marcelomata/MATLAB/2 Spring 2017/Nonlinear Control/html/HW1_01.png

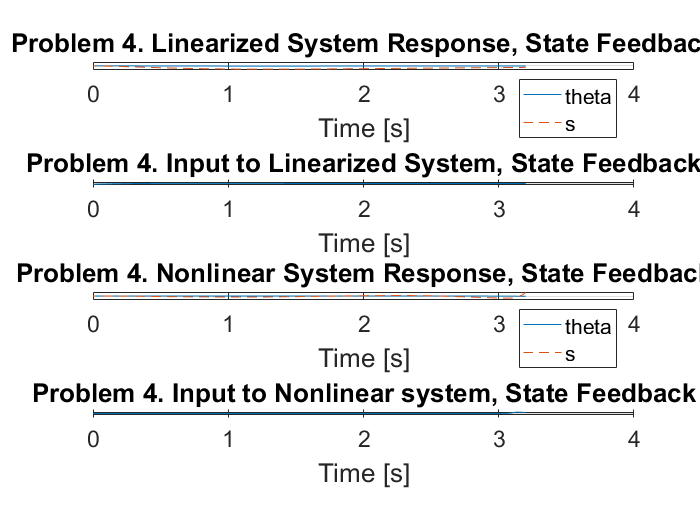
2 Spring 2017/Nonlinear Control/html/HW1_01.png
