marcelomata/MATLAB/2 Spring 2017/Nonlinear Control/HW2/fig2.jpg

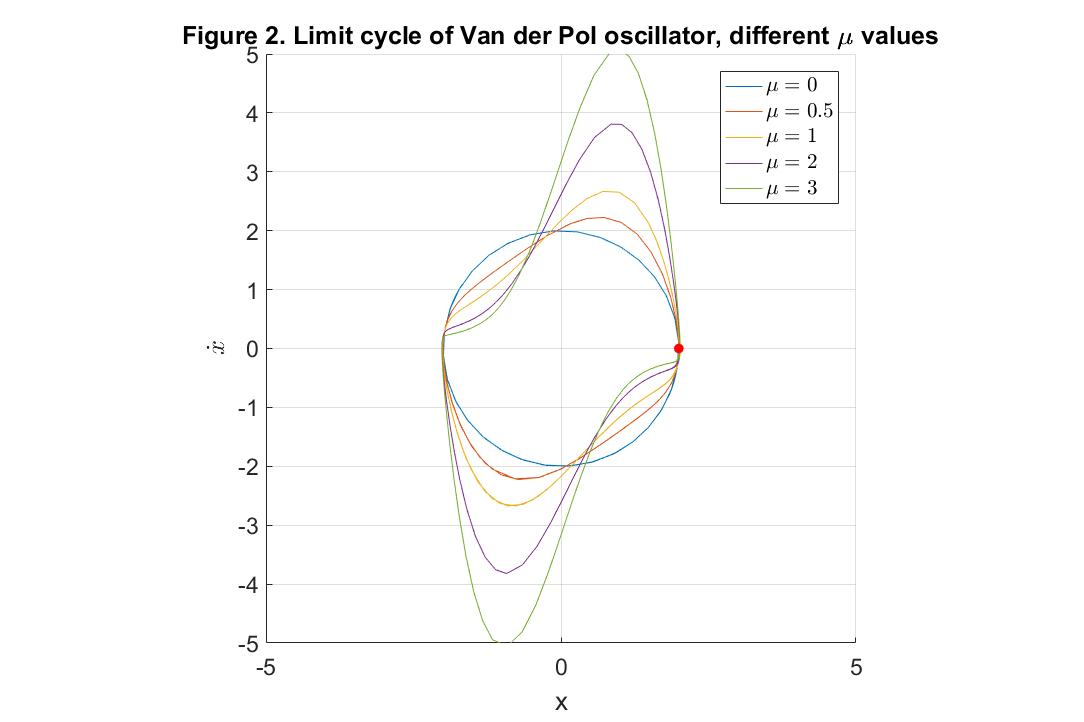
2 Spring 2017/Nonlinear Control/HW2/fig2.jpg
