marcelomata/MATLAB/2 Spring 2017/Nonlinear Control/HW2/fig4.jpg

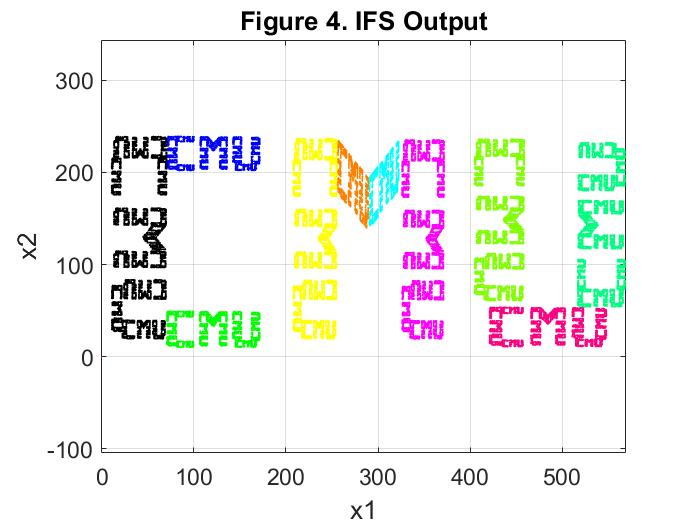
2 Spring 2017/Nonlinear Control/HW2/fig4.jpg
