marcelomata/MATLAB/2 Spring 2017/Nonlinear Control/HW8/html/HW8_3_01.png

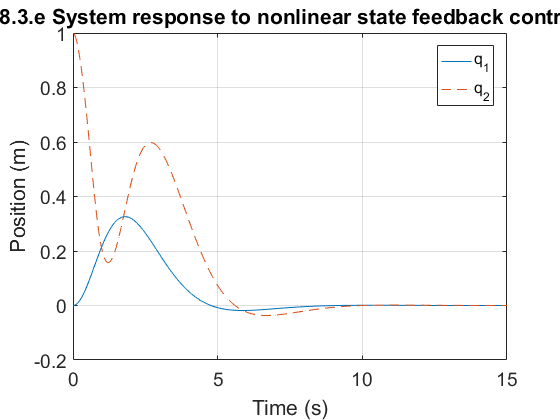
2 Spring 2017/Nonlinear Control/HW8/html/HW8_3_01.png
