marcelomata/MATLAB/Minitaur models/SM_Contact_Forces_Lib/SM_Contact_Forces_Lib_v3p4_R16a/Examples/3D/Robot_2_Whl/Animations/Robot_2_Whl_Anim.gif

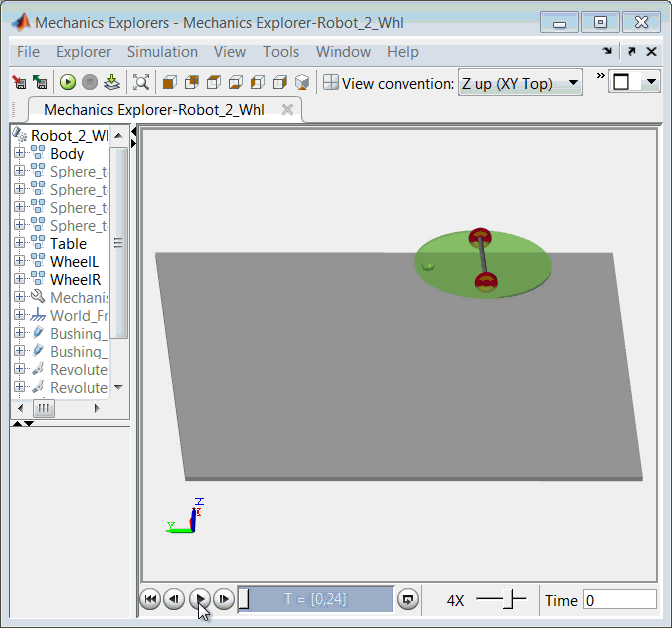
Minitaur models/SM_Contact_Forces_Lib/SM_Contact_Forces_Lib_v3p4_R16a/Examples/3D/Robot_2_Whl/Animations/Robot_2_Whl_Anim.gif
