marcelomata/MATLAB/Minitaur models/SM_Contact_Forces_Lib/SM_Contact_Forces_Lib_v3p5_R16b/Examples/3D/Gripper_2Belts/Animations/Gripper_2Belts_Anim.gif

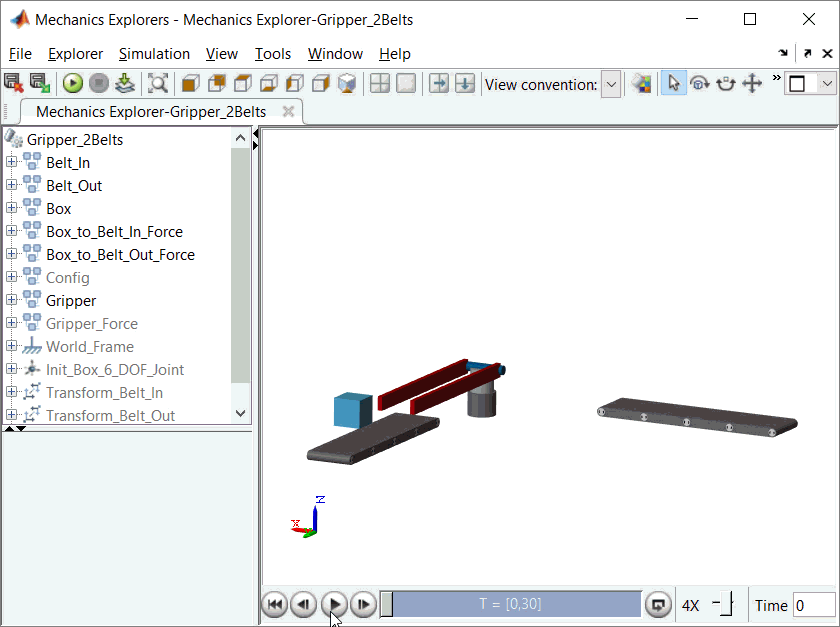
Minitaur models/SM_Contact_Forces_Lib/SM_Contact_Forces_Lib_v3p5_R16b/Examples/3D/Gripper_2Belts/Animations/Gripper_2Belts_Anim.gif
