marcelomata/MATLAB/Research/CMAES and corresponding slx model/bounding GRFs.jpg

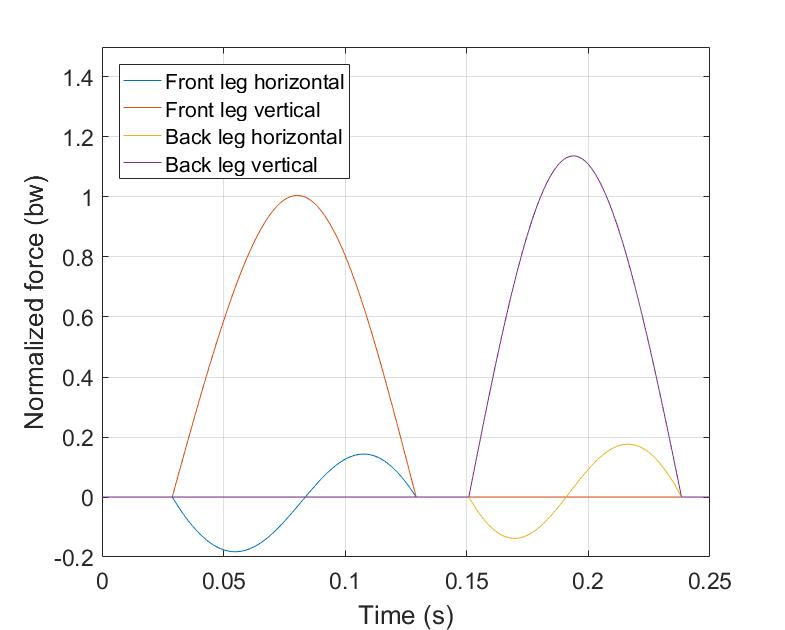
Research/CMAES and corresponding slx model/bounding GRFs.jpg
