marcelomata/MATLAB/Research/CMAES and corresponding slx model/pronking GRFs.jpg

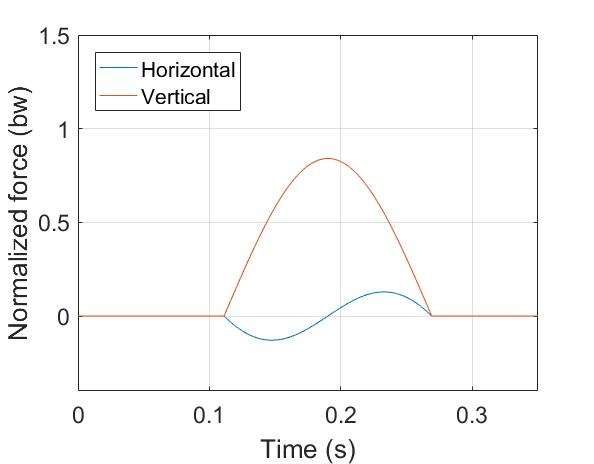
Research/CMAES and corresponding slx model/pronking GRFs.jpg
