marcelomata/MATLAB/Research/CMAES and corresponding slx model/trotting GRFs.jpg

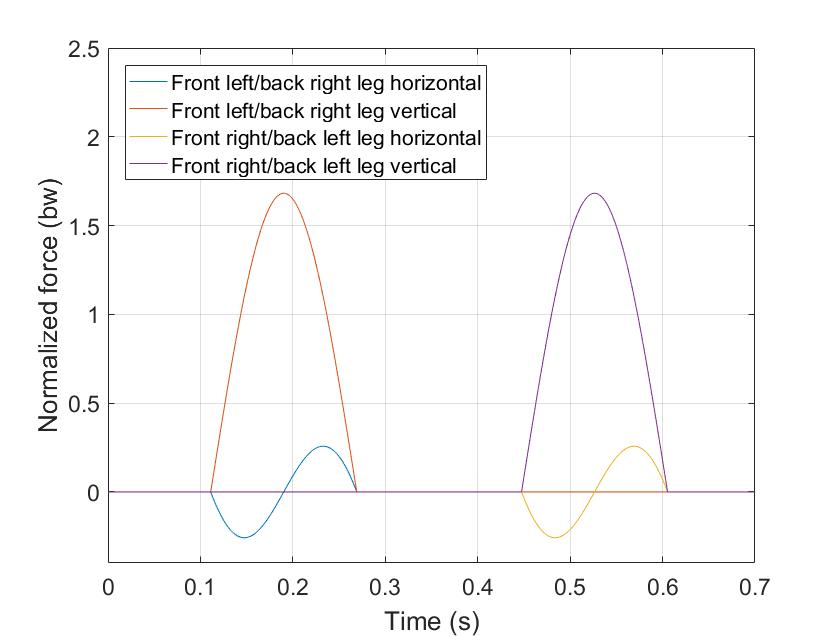
Research/CMAES and corresponding slx model/trotting GRFs.jpg
