marcelomata/MATLAB/Research/Figures/Apex Return Map dx0 t5 passive.jpg

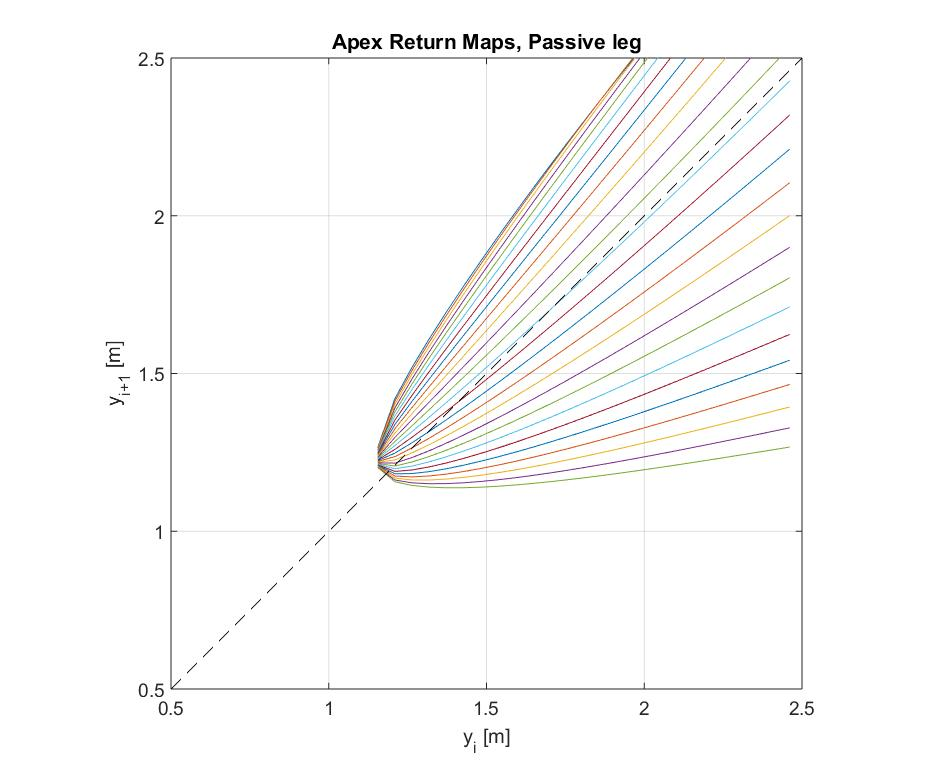
Research/Figures/Apex Return Map dx0 t5 passive.jpg
