marcelomata/MATLAB/Research/Figures/Apex Return Map dx0 t5.jpg

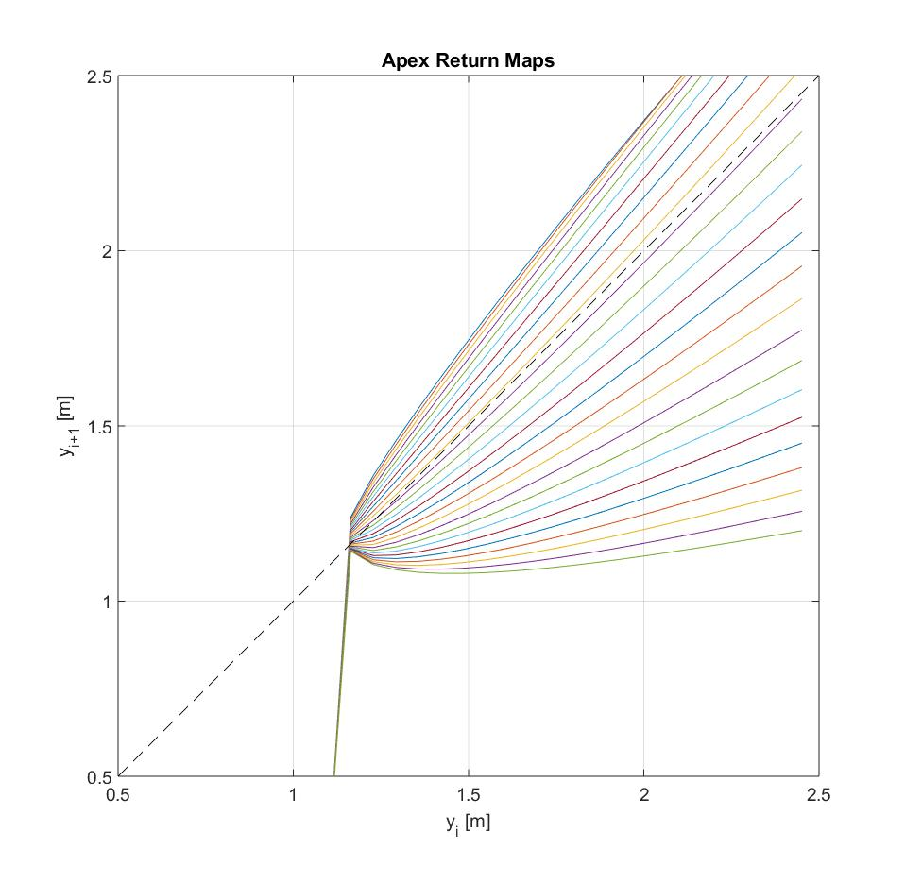
Research/Figures/Apex Return Map dx0 t5.jpg
