marcelomata/MATLAB/Research/Figures/Apex Return Map dx0.jpg

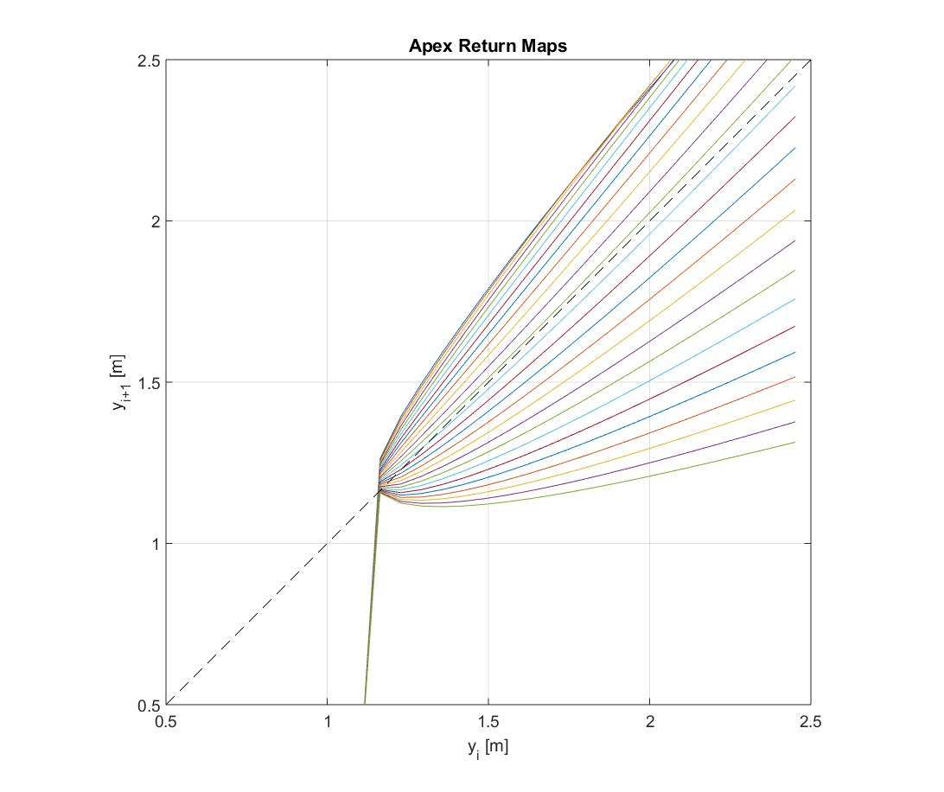
Research/Figures/Apex Return Map dx0.jpg
