marcelomata/MATLAB/Research/Figures/x_vs_L_t0_a68.jpg

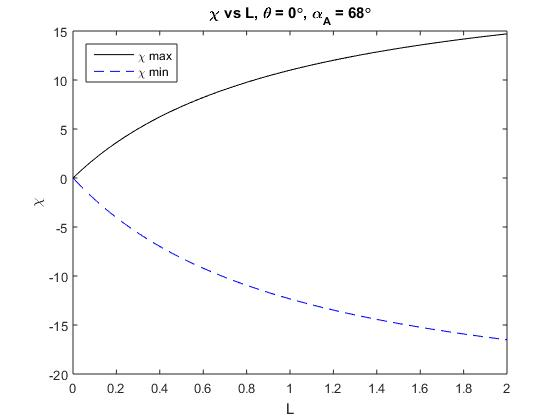
Research/Figures/x_vs_L_t0_a68.jpg
