marcelomata/MATLAB/Research/Figures/x_vs_L_t5_a68.jpg

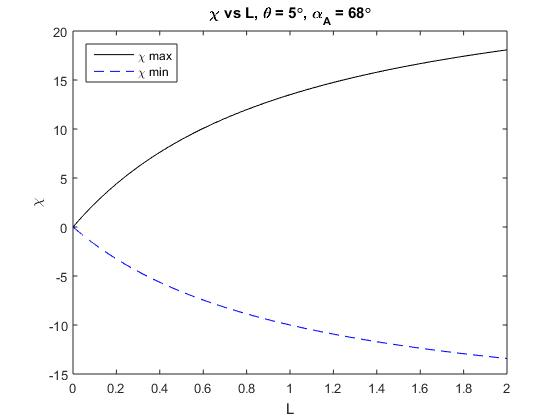
Research/Figures/x_vs_L_t5_a68.jpg
