marcelomata/MATLAB/Research/Figures/x_vs_L_t-5_a68.jpg

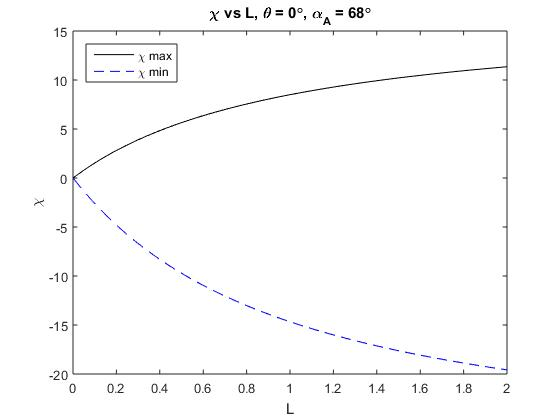
Research/Figures/x_vs_L_t-5_a68.jpg
