marcelomata/MATLAB/Research/Figures/y and dx over time.JPG

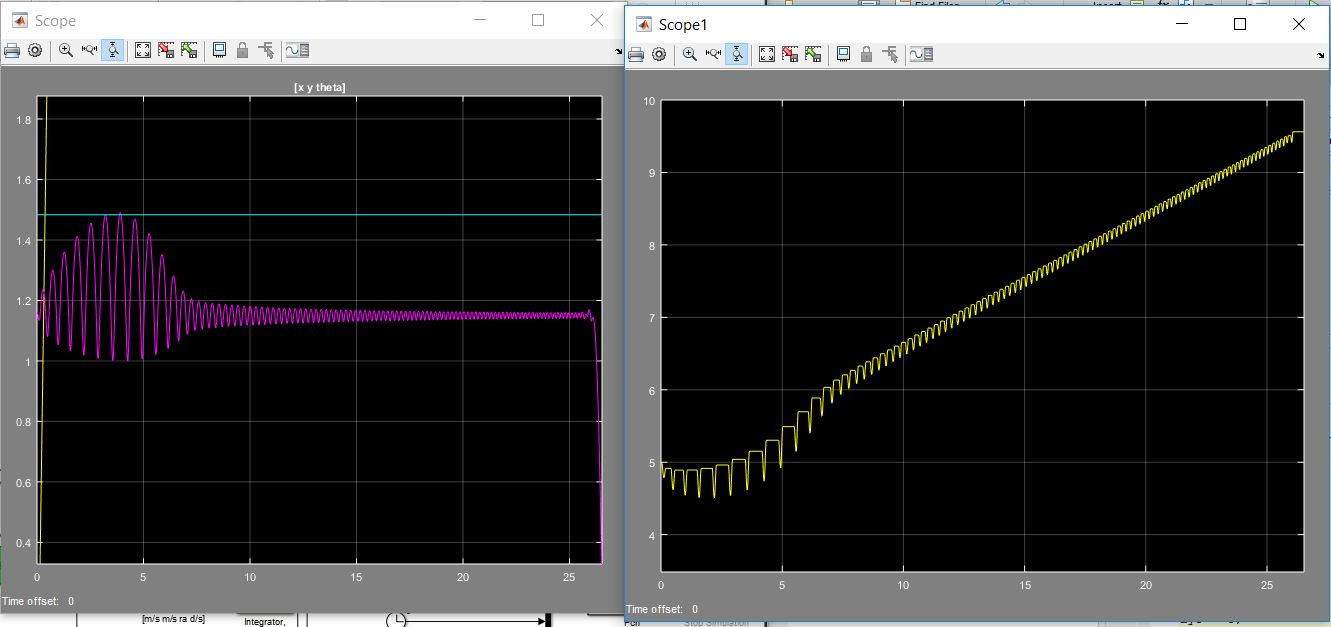
Research/Figures/y and dx over time.JPG
