marcelomata/MATLAB/Minitaur models/SM_Contact_Forces_Lib/SM_Contact_Forces_Lib_v3p0_R14b/Scripts_Data/CFR_Results_REF.xlsx

Sheet: R14a
 | Contact Forces Tests | 8.3.0.532 (R2014a) |  |  | 2014-09-17 17:47
 |  |  | Linear, No Friction |  | Linear, Stick-Slip C |  | Nonlin., No Friction |  | Nonlin., Stick-Slip C
# | Model | Stop Time | # Steps | Sim Time | # Steps | Sim Time | # Steps | Sim Time | # Steps | Sim Time
1 | Collision_01_Ball_Infinite_Plane | 20.00 | 3923 | 0.606 | 3923 | 0.403 | 3923 | 0.344 | 3923 | 0.337
2 | Collision_02_Disk_Finite_Plane_Fixed | 4.00 | 671 | 0.218 | 995 | 0.143 | 730 | 0.096 | 1007 | 0.148
3 | Collision_03_Disk_Finite_Plane_Spin | 1.50 | 324 | 0.176 | 397 | 0.072 | 347 | 0.065 | 423 | 0.076
4 | Collision_04_Disks_in_Box | 3.00 | 3788 | 3.692 | 4326 | 4.442 | 5040 | 5.2 | 6174 | 7.094
5 | Collision_05_Disk_in_Ring | 5.00 | 1962 | 0.547 | 2616 | 0.428 | 2200 | 0.339 | 2917 | 0.479
6 | Collision_06_Catapult | 1.20 | 633 | 0.385 | 626 | 0.24 | 724 | 0.229 | 710 | 0.256
7 | Collision_07_Ball_Finite_Plane_Float | 1.50 | 211 | 0.247 | 214 | 0.122 | 222 | 0.124 | 227 | 0.126
8 | Collision_08_Compare_Forces | 5.00 | 9492 | 4.248 | 18561 | 8.979 | 12244 | 6112 | 21021 | 10970
9 | Friction_01_Box_on_Ramp_Constraint | 10.00 | 1189 | 0.232 | 1189 | 0.103 | 1189 | 0.107 | 1189 | 0.106
10 | Friction_02_Box_on_Ramp | 10.00 | 1325 | 0.272 | 1440 | 0.405 | 1430 | 0.308 | 1561 | 0.386
11 | Friction_03_Double_Pendulum_Constraint | 45.00 | 5782 | 0.488 | 5782 | 0.448 | 5782 | 0.456 | 5782 | 0.446
12 | Friction_04_Disk_Rolling_on_Ramp | 4.00 | 725 | 0.276 | 873 | 0.193 | 816 | 0.166 | 999 | 0.201
13 | Friction_05_Beam_on_Wheel | 10.00 | 1328 | 0.412 | 1487 | 0.511 | 1426 | 0.309 | 1515 | 0.399
14 | Friction_06_Disk_on_Disk | 15.00 | 6294 | 2039 | 6075 | 2063 | 5485 | 1871 | 6271 | 2422
15 | Friction_07_Floating_Disks | 2.00 | 290 | 0.24 | 300 | 0.108 | 315 | 0.108 | 339 | 0.141
16 | Friction_08_Disks_and_Ring | 30.00 | 3442 | 1223 | 3723 | 1076 | 3524 | 0.971 | 3807 | 1180
17 | Friction_09_Ring_on_Disk_Float | 50.00 | 7341 | 1532 | 6470 | 1163 | 98944 | 15206 | 99327 | 17094
18 | Cam_Follower | 15.00 | 2243 | 1855 | 2284 | 1440 | 2716 | 1587 | 2844 | 1745
19 | Geneva_Drive | 30.00 | 5343 | 7034 | 5670 | 7776 | 5228 | 6870 | 5662 | 8573
20 | Spinning_Boxes | 12.00 | 14766 | 14031 | 15820 | 14763 | 22948 | 21331 | 18430 | 17440
21 | Mini Golf Hole 1 | 33.72 | 8975 | 6483 | n/a | n/a | n/a | n/a | n/a | n/a
22 | Mini Golf Hole 2 | 32.20 | 8880 | 7425 | n/a | n/a | n/a | n/a | n/a | n/a
23 | Mini Golf Hole 3 | 59.18 | 15368 | 15626 | n/a | n/a | n/a | n/a | n/a | n/a
24 | Mini Golf Hole 4 | 39.02 | 11421 | 12229 | n/a | n/a | n/a | n/a | n/a | n/a
25 | Mini Golf Hole 5 | 34.66 | 9386 | 7715 | n/a | n/a | n/a | n/a | n/a | n/a
26 | Mini Golf Hole 6 | 41.07 | 12275 | 21750 | n/a | n/a | n/a | n/a | n/a | n/a
27 | Mini Golf Hole 7 | 41.27 | 11517 | 14841 | n/a | n/a | n/a | n/a | n/a | n/a
28 | Mini Golf Hole 8 | 45.28 | 12691 | 21209 | n/a | n/a | n/a | n/a | n/a | n/a
29 | Mini Golf Hole 9 | 27.72 | 9248 | 18812 | n/a | n/a | n/a | n/a | n/a | n/a

Sheet: R15a
 | Contact Forces Tests | 8.5.0.197613 (R2015a) |  |  | 2015-08-05 00:29
 |  |  | Linear, No Friction |  | Linear, Stick-Slip C |  | Nonlin., No Friction |  | Nonlin., Stick-Slip C
# | Model | Stop Time | # Steps | Sim Time | # Steps | Sim Time | # Steps | Sim Time | # Steps | Sim Time
1 | Collision_01_Ball_Infinite_Plane | 20.00 | 3960 | 0.49 | 3960 | 0.25 | 3960 | 0.20 | 3960 | 0.22
2 | Collision_02_Disk_Finite_Plane_Fixed | 4.00 | 671 | 0.12 | 980 | 0.09 | 703 | 0.06 | 999 | 0.09
3 | Collision_03_Disk_Finite_Plane_Spin | 1.50 | 340 | 0.09 | 395 | 0.08 | 356 | 0.05 | 425 | 0.06
4 | Collision_04_Disks_in_Box | 3.00 | 3819 | 2.22 | 4402 | 2.45 | 5187 | 2.91 | 6215 | 3.99
5 | Collision_05_Disk_in_Ring | 5.00 | 1964 | 0.29 | 2563 | 0.23 | 2200 | 0.18 | 2989 | 0.26
6 | Collision_06_Catapult | 1.20 | 638 | 0.20 | 645 | 0.12 | 724 | 0.13 | 734 | 0.15
7 | Collision_07_Ball_Finite_Plane_Float | 1.50 | 213 | 0.08 | 214 | 0.04 | 223 | 0.05 | 228 | 0.05
8 | Collision_08_Compare_Forces | 5.00 | 9846 | 2.79 | 18411 | 5.26 | 12950 | 3.94 | 20891 | 7.03
9 | Friction_01_Box_on_Ramp_Constraint | 10.00 | 1211 | 0.13 | 1211 | 0.07 | 1211 | 0.08 | 1211 | 0.07
10 | Friction_02_Box_on_Ramp | 10.00 | 1304 | 0.21 | 1438 | 0.24 | 1419 | 0.22 | 1496 | 0.22
11 | Friction_03_Double_Pendulum_Constraint | 45.00 | 5738 | 0.39 | 5738 | 0.29 | 5738 | 0.27 | 5738 | 0.37
12 | Friction_04_Disk_Rolling_on_Ramp | 4.00 | 732 | 0.11 | 872 | 0.09 | 831 | 0.08 | 944 | 0.10
13 | Friction_05_Beam_on_Wheel | 10.00 | 1305 | 0.18 | 1418 | 0.14 | 1415 | 0.14 | 1512 | 0.16
14 | Friction_06_Disk_on_Disk | 15.00 | 6552 | 1.14 | 6019 | 1.22 | 5498 | 0.99 | 6299 | 1.30
15 | Friction_07_Floating_Disks | 2.00 | 277 | 0.12 | 299 | 0.07 | 308 | 0.08 | 332 | 0.09
16 | Friction_08_Disks_and_Ring | 30.00 | 3413 | 0.59 | 3662 | 0.70 | 3526 | 0.47 | 3775 | 0.60
17 | Friction_09_Ring_on_Disk_Float | 50.00 | 7203 | 0.73 | 6785 | 0.65 | 98767 | 9.38 | 99307 | 9.93
18 | Cam_Follower | 15.00 | 2276 | 0.87 | 2246 | 0.85 | 2688 | 0.97 | 2842 | 1.11
19 | Geneva_Drive | 30.00 | 5242 | 3.59 | 5863 | 4.63 | 5160 | 4.18 | 5673 | 4.81
20 | Spinning_Boxes | 12.00 | 13968 | 6.53 | 15451 | 7.41 | 24009 | 11.35 | 22677 | 10.60
21 | Belts_01_Two_Belts | 20.00 | 3700 | 2.24 | 4458 | 3.38 | 3798 | 2.26 | 4716 | 3.65
22 | Coll3D_01_Ball_Plane_Fixed | 7.50 | 941 | 0.23 | 1018 | 0.12 | 966 | 0.09 | 1074 | 0.13
23 | Coll3D_02_Ball_Plane_Spin | 5.00 | 722 | 0.11 | 845 | 0.13 | 744 | 0.12 | 863 | 0.15
24 | Coll3D_03_Balls_in_Box | 20.00 | 10470 | 9.81 | 12196 | 16.47 | 12178 | 13.92 | 13497 | 22.39
25 | Coll3D_04_Ball_in_Tube_Fixed | 5.00 | 632 | 0.12 | 914 | 0.18 | 653 | 0.10 | 980 | 0.20
26 | Coll3D_05_Ball_Peg_Board | 20.00 | 2428 | 1.13 | 4898 | 6.33 | 2508 | 1.11 | 5349 | 7.38
27 | Coll3D_06_Ball_in_Ball | 10.00 | 2635 | 0.51 | 4096 | 0.92 | 3029 | 0.58 | 4353 | 0.96
28 | Frict3D_01_Box_on_Table | 36.00 | 4647 | 0.81 | 6995 | 2.09 | 4646 | 0.81 | 6996 | 2.19
29 | Frict3D_02_Ball_on_Table | 48.00 | 5773 | 0.70 | 8799 | 2.63 | 5756 | 0.71 | 8552 | 2.70
30 | Frict3D_03_Board_on_Balls | 36.00 | 4175 | 0.94 | 4632 | 1.48 | 4256 | 1.14 | 4807 | 1.71
31 | Frict3D_04_Ball_on_Ball | 40.00 | 4964 | 0.53 | 5451 | 0.77 | 4879 | 0.52 | 5234 | 0.70
32 | Frict3D_05_Tube_on_Balls | 36.00 | 4200 | 1.54 | 8382 | 5.97 | 4213 | 1.72 | 9181 | 6.86
33 | Frict3D_06_Ball_on_Balls | 36.00 | 4601 | 1.30 | 4556 | 1.69 | 4746 | 1.59 | 4615 | 1.80
34 | Frict3D_07_Ball_in_Ball | 40.00 | 7029 | 0.84 | 7563 | 1.13 | 7419 | 0.91 | 7950 | 1.30
35 | Robot_2_Whl | 24.00 | 8146 | 4.13 | 6522 | 5.92 | 8479 | 4.70 | 6390 | 6.05
36 | Mini Golf Hole 1 | 33.72 | 9272 | 3.89 | n/a | n/a | n/a | n/a | n/a | n/a
37 | Mini Golf Hole 2 | 32.19 | 9164 | 4.37 | n/a | n/a | n/a | n/a | n/a | n/a
38 | Mini Golf Hole 3 | 59.19 | 15505 | 8.63 | n/a | n/a | n/a | n/a | n/a | n/a
39 | Mini Golf Hole 4 | 39.01 | 11256 | 6.58 | n/a | n/a | n/a | n/a | n/a | n/a
40 | Mini Golf Hole 5 | 34.64 | 9236 | 4.45 | n/a | n/a | n/a | n/a | n/a | n/a
41 | Mini Golf Hole 6 | 40.98 | 12026 | 9.92 | n/a | n/a | n/a | n/a | n/a | n/a
42 | Mini Golf Hole 7 | 41.28 | 12079 | 7.83 | n/a | n/a | n/a | n/a | n/a | n/a
43 | Mini Golf Hole 8 | 45.28 | 12970 | 11.76 | n/a | n/a | n/a | n/a | n/a | n/a
44 | Mini Golf Hole 9 | 27.71 | 8947 | 8.11 | n/a | n/a | n/a | n/a | n/a | n/a

Sheet: R15b
 | Contact Forces Tests | 8.6.0.232648 (R2015b) |  |  | 2015-08-05 10:22
 |  |  | Linear, No Friction |  | Linear, Stick-Slip C |  | Nonlin., No Friction |  | Nonlin., Stick-Slip C
# | Model | Stop Time | # Steps | Sim Time | # Steps | Sim Time | # Steps | Sim Time | # Steps | Sim Time
1 | Collision_01_Ball_Infinite_Plane | 20.00 | 3960 | 0.61 | 3960 | 0.26 | 3960 | 0.26 | 3960 | 0.22
2 | Collision_02_Disk_Finite_Plane_Fixed | 4.00 | 671 | 0.18 | 980 | 0.13 | 703 | 0.11 | 999 | 0.13
3 | Collision_03_Disk_Finite_Plane_Spin | 1.50 | 340 | 0.18 | 395 | 0.09 | 356 | 0.10 | 425 | 0.09
4 | Collision_04_Disks_in_Box | 3.00 | 3819 | 2.12 | 4402 | 2.50 | 5187 | 3.22 | 6215 | 3.82
5 | Collision_05_Disk_in_Ring | 5.00 | 1964 | 0.35 | 2563 | 0.29 | 2200 | 0.26 | 2989 | 0.41
6 | Collision_06_Catapult | 1.20 | 612 | 0.48 | 628 | 0.28 | 762 | 0.17 | 721 | 0.29
7 | Collision_07_Ball_Finite_Plane_Float | 1.50 | 213 | 0.28 | 214 | 0.14 | 223 | 0.13 | 228 | 0.14
8 | Collision_08_Compare_Forces | 5.00 | 9846 | 2.86 | 18411 | 5.88 | 12950 | 4.22 | 20891 | 7.05
9 | Friction_01_Box_on_Ramp_Constraint | 10.00 | 1211 | 0.31 | 1211 | 0.17 | 1211 | 0.17 | 1211 | 0.17
10 | Friction_02_Box_on_Ramp | 10.00 | 1304 | 0.69 | 1438 | 0.40 | 1419 | 0.38 | 1496 | 0.41
11 | Friction_03_Double_Pendulum_Constraint | 45.00 | 5808 | 0.64 | 5808 | 0.43 | 5808 | 0.44 | 5808 | 0.43
12 | Friction_04_Disk_Rolling_on_Ramp | 4.00 | 732 | 0.34 | 872 | 0.19 | 831 | 0.20 | 944 | 0.21
13 | Friction_05_Beam_on_Wheel | 10.00 | 1325 | 0.45 | 1403 | 0.29 | 1415 | 0.21 | 1523 | 0.28
14 | Friction_06_Disk_on_Disk | 15.00 | 6552 | 1.30 | 6019 | 1.26 | 5498 | 0.96 | 6299 | 1.43
15 | Friction_07_Floating_Disks | 2.00 | 277 | 0.38 | 299 | 0.19 | 308 | 0.20 | 332 | 0.29
16 | Friction_08_Disks_and_Ring | 30.00 | 3413 | 0.55 | 3646 | 0.81 | 3535 | 0.71 | 3782 | 0.77
17 | Friction_09_Ring_on_Disk_Float | 50.00 | 7328 | 1.05 | 6896 | 0.88 | 98759 | 10.79 | 99463 | 11.81
18 | Cam_Follower | 15.00 | 2247 | 1.15 | 2253 | 0.99 | 2721 | 1.66 | 2833 | 1.69
19 | Geneva_Drive | 30.00 | 5242 | 4.28 | 5863 | 5.37 | 5160 | 5.28 | 5673 | 4.98
20 | Spinning_Boxes | 12.00 | 15311 | 7.98 | 16538 | 8.80 | 22374 | 10.83 | 20456 | 10.04
21 | Belts_01_Two_Belts | 20.00 | 3687 | 2.95 | 4491 | 3.45 | 3787 | 2.40 | 4562 | 3.50
22 | Coll3D_01_Ball_Plane_Fixed | 7.50 | 941 | 0.62 | 1018 | 0.23 | 966 | 0.20 | 1074 | 0.23
23 | Coll3D_02_Ball_Plane_Spin | 5.00 | 722 | 0.36 | 845 | 0.23 | 744 | 0.23 | 863 | 0.45
24 | Coll3D_03_Balls_in_Box | 20.00 | 10470 | 10.70 | 12196 | 19.58 | 12178 | 18.47 | 13497 | 27.58
25 | Coll3D_04_Ball_in_Tube_Fixed | 5.00 | 632 | 0.42 | 914 | 0.32 | 653 | 0.24 | 980 | 0.30
26 | Coll3D_05_Ball_Peg_Board | 20.00 | 2428 | 1.21 | 4898 | 7.24 | 2508 | 1.21 | 5349 | 8.33
27 | Coll3D_06_Ball_in_Ball | 10.00 | 2635 | 0.77 | 4096 | 1.48 | 3029 | 0.82 | 4353 | 1.51
28 | Frict3D_01_Box_on_Table | 36.00 | 4656 | 1.07 | 6867 | 2.23 | 4711 | 1.01 | 6890 | 2.23
29 | Frict3D_02_Ball_on_Table | 48.00 | 5803 | 0.88 | 9169 | 3.17 | 5941 | 0.85 | 9256 | 3.70
30 | Frict3D_03_Board_on_Balls | 36.00 | 4175 | 1.49 | 4632 | 2.31 | 4256 | 1.62 | 4807 | 2.25
31 | Frict3D_04_Ball_on_Ball | 40.00 | 4964 | 0.82 | 5451 | 1.06 | 4879 | 0.75 | 5234 | 0.96
32 | Frict3D_05_Tube_on_Balls | 36.00 | 4175 | 2.10 | 8292 | 7.14 | 4185 | 2.21 | 8859 | 7.15
33 | Frict3D_06_Ball_on_Balls | 36.00 | 4601 | 2.09 | 4556 | 1.75 | 4746 | 1.56 | 4615 | 1.77
34 | Frict3D_07_Ball_in_Ball | 40.00 | 7029 | 1.14 | 7563 | 1.48 | 7419 | 1.05 | 7950 | 1.70
35 | Robot_2_Whl | 24.00 | 8050 | 4.10 | 6469 | 5.98 | 8142 | 4.26 | 6433 | 5.72
36 | Mini Golf Hole 1 | 33.72 | 9272 | 4.51 | n/a | n/a | n/a | n/a | n/a | n/a
37 | Mini Golf Hole 2 | 32.19 | 9164 | 5.12 | n/a | n/a | n/a | n/a | n/a | n/a
38 | Mini Golf Hole 3 | 59.19 | 15505 | 9.79 | n/a | n/a | n/a | n/a | n/a | n/a
39 | Mini Golf Hole 4 | 39.01 | 11256 | 7.16 | n/a | n/a | n/a | n/a | n/a | n/a
40 | Mini Golf Hole 5 | 34.64 | 9236 | 4.88 | n/a | n/a | n/a | n/a | n/a | n/a
41 | Mini Golf Hole 6 | 40.98 | 12026 | 10.95 | n/a | n/a | n/a | n/a | n/a | n/a
42 | Mini Golf Hole 7 | 41.28 | 12252 | 9.17 | n/a | n/a | n/a | n/a | n/a | n/a
43 | Mini Golf Hole 8 | 45.28 | 12970 | 12.47 | n/a | n/a | n/a | n/a | n/a | n/a
44 | Mini Golf Hole 9 | 27.71 | 8931 | 8.51 | n/a | n/a | n/a | n/a | n/a | n/a

Sheet: Delta15b
 | Contact Forces Tests | 8.6.0.232648 (R2015b) |  |  | 2015-08-05 00:09
 |  |  | Linear, No Friction |  | Linear, Stick-Slip C |  | Nonlin., No Friction |  | Nonlin., Stick-Slip C
# | Model | Stop Time | # Steps | Sim Time | # Steps | Sim Time | # Steps | Sim Time | # Steps | Sim Time
1 | Collision_01_Ball_Infinite_Plane | 20.00 | 0.00% | 23.17% | 0.00% | 3.97% | 0.00% | 27.80% | 0.00% | 1.82%
2 | Collision_02_Disk_Finite_Plane_Fixed | 4.00 | 0.00% | 43.09% | 0.00% | 54.12% | 0.00% | 71.43% | 0.00% | 46.67%
3 | Collision_03_Disk_Finite_Plane_Spin | 1.50 | 0.00% | 103.41% | 0.00% | 17.50% | 0.00% | 88.24% | 0.00% | 55.36%
4 | Collision_04_Disks_in_Box | 3.00 | 0.00% | -4.77% | 0.00% | 1.96% | 0.00% | 10.94% | 0.00% | -4.36%
5 | Collision_05_Disk_in_Ring | 5.00 | 0.00% | 23.78% | 0.00% | 24.89% | 0.00% | 37.84% | 0.00% | 62.11%
6 | Collision_06_Catapult | 1.20 | 4.08% | 148.21% | 2.64% | 127.05% | 5.25% | 29.92% | -1.77% | 93.33%
7 | Collision_07_Ball_Finite_Plane_Float | 1.50 | 0.00% | 234.94% | 0.00% | 230.23% | 0.00% | 179.17% | 0.00% | 176.00%
8 | Collision_08_Compare_Forces | 5.00 | 0.00% | 2.47% | 0.00% | 11.66% | 0.00% | 7.27% | 0.00% | 0.33%
9 | Friction_01_Box_on_Ramp_Constraint | 10.00 | 0.00% | 146.83% | 0.00% | 150.75% | 0.00% | 121.05% | 0.00% | 150.00%
10 | Friction_02_Box_on_Ramp | 10.00 | 0.00% | 231.88% | 0.00% | 64.05% | 0.00% | 73.27% | 0.00% | 82.14%
11 | Friction_03_Double_Pendulum_Constraint | 45.00 | 1.22% | 64.86% | -1.22% | 49.65% | 1.22% | 61.25% | 1.22% | 17.12%
12 | Friction_04_Disk_Rolling_on_Ramp | 4.00 | 0.00% | 210.00% | 0.00% | 118.82% | 0.00% | 150.63% | 0.00% | 105.94%
13 | Friction_05_Beam_on_Wheel | 10.00 | 1.53% | 143.78% | 1.06% | 109.42% | 0.00% | 50.00% | 0.73% | 73.12%
14 | Friction_06_Disk_on_Disk | 15.00 | 0.00% | 14.37% | 0.00% | 3.44% | 0.00% | -2.64% | 0.00% | 9.62%
15 | Friction_07_Floating_Disks | 2.00 | 0.00% | 225.64% | 0.00% | 160.81% | 0.00% | 163.16% | 0.00% | 238.37%
16 | Friction_08_Disks_and_Ring | 30.00 | 0.00% | -6.13% | 0.44% | 16.33% | 0.26% | 49.89% | 0.19% | 28.29%
17 | Friction_09_Ring_on_Disk_Float | 50.00 | 1.74% | 44.17% | -1.64% | 36.43% | -0.01% | 15.06% | 0.16% | 18.95%
18 | Cam_Follower | 15.00 | -1.27% | 32.18% | -0.31% | 15.91% | 1.23% | 71.03% | -0.32% | 52.61%
19 | Geneva_Drive | 30.00 | 0.00% | 19.27% | 0.00% | 16.09% | 0.00% | 26.22% | 0.00% | 3.45%
20 | Spinning_Boxes | 12.00 | 9.61% | 22.22% | -7.04% | 18.78% | -6.81% | -4.64% | -9.79% | -5.27%
21 | Belts_01_Two_Belts | 20.00 | -0.35% | 31.77% | -0.74% | 1.98% | -0.29% | 6.28% | -3.27% | -4.03%
22 | Coll3D_01_Ball_Plane_Fixed | 7.50 | 0.00% | 169.87% | 0.00% | 93.97% | 0.00% | 122.47% | 0.00% | 75.76%
23 | Coll3D_02_Ball_Plane_Spin | 5.00 | 0.00% | 223.42% | 0.00% | 79.39% | 0.00% | 83.74% | 0.00% | 203.36%
24 | Coll3D_03_Balls_in_Box | 20.00 | 0.00% | 9.07% | 0.00% | 18.91% | 0.00% | 32.65% | 0.00% | 23.19%
25 | Coll3D_04_Ball_in_Tube_Fixed | 5.00 | 0.00% | 257.26% | 0.00% | 78.77% | 0.00% | 142.00% | 0.00% | 47.26%
26 | Coll3D_05_Ball_Peg_Board | 20.00 | 0.00% | 6.54% | 0.00% | 14.40% | 0.00% | 8.52% | 0.00% | 12.80%
27 | Coll3D_06_Ball_in_Ball | 10.00 | 0.00% | 50.58% | 0.00% | 61.57% | 0.00% | 39.73% | 0.00% | 56.64%
28 | Frict3D_01_Box_on_Table | 36.00 | 0.19% | 32.75% | 1.83% | 6.56% | 1.40% | 23.71% | -1.52% | 2.01%
29 | Frict3D_02_Ball_on_Table | 48.00 | 0.52% | 25.75% | -4.21% | 20.46% | 3.21% | 20.08% | 8.23% | 37.26%
30 | Frict3D_03_Board_on_Balls | 36.00 | 0.00% | 58.43% | 0.00% | 56.84% | 0.00% | 42.27% | 0.00% | 32.03%
31 | Frict3D_04_Ball_on_Ball | 40.00 | 0.00% | 53.93% | 0.00% | 37.08% | 0.00% | 45.05% | 0.00% | 37.52%
32 | Frict3D_05_Tube_on_Balls | 36.00 | -0.60% | 36.12% | 1.07% | 19.64% | -0.66% | 28.85% | -3.51% | 4.21%
33 | Frict3D_06_Ball_on_Balls | 36.00 | 0.00% | 60.52% | 0.00% | 3.67% | 0.00% | -1.39% | 0.00% | -1.61%
34 | Frict3D_07_Ball_in_Ball | 40.00 | 0.00% | 34.91% | 0.00% | 30.74% | 0.00% | 16.32% | 0.00% | 30.86%
35 | Robot_2_Whl | 24.00 | -1.18% | -0.58% | 0.81% | 1.00% | -3.97% | -9.34% | 0.67% | -5.53%
36 | Mini Golf Hole 1 | 33.72 | 0.00% | 15.84% | n/a | n/a | n/a | n/a | n/a | n/a
37 | Mini Golf Hole 2 | 32.19 | 0.00% | 17.11% | n/a | n/a | n/a | n/a | n/a | n/a
38 | Mini Golf Hole 3 | 59.19 | 0.00% | 13.36% | n/a | n/a | n/a | n/a | n/a | n/a
39 | Mini Golf Hole 4 | 39.01 | 0.00% | 8.88% | n/a | n/a | n/a | n/a | n/a | n/a
40 | Mini Golf Hole 5 | 34.64 | 0.00% | 9.55% | n/a | n/a | n/a | n/a | n/a | n/a
41 | Mini Golf Hole 6 | 40.98 | 0.00% | 10.35% | n/a | n/a | n/a | n/a | n/a | n/a
42 | Mini Golf Hole 7 | 41.28 | 1.43% | 17.09% | n/a | n/a | n/a | n/a | n/a | n/a
43 | Mini Golf Hole 8 | 45.28 | 0.00% | 6.05% | n/a | n/a | n/a | n/a | n/a | n/a
44 | Mini Golf Hole 9 | 27.71 | -0.18% | 4.89% | n/a | n/a | n/a | n/a | n/a | n/a
