marcelomata/MATLAB/Minitaur models/resources/cad/ash-minitaur-solidworks-assembly/Ghost Minitaur.SLDASM

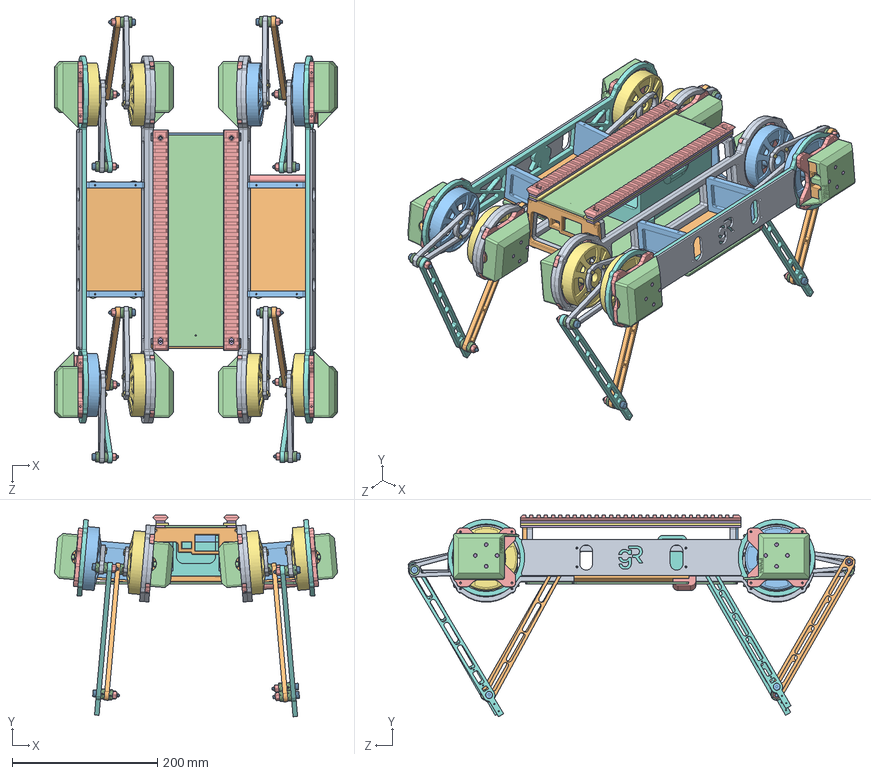
[picture p30: CAD file, 2017-04-27]
Minitaur models/resources/cad/ash-minitaur-solidworks-assembly/Ghost Minitaur.SLDASM
389.9 x 277.7 x 615.7 mm
ghost minitaur side plate new x 4
bllc0p61 new x 8
DYS 8108 new x 3
module u8 bllc cover XT60 new x 8
module plate u8 moreholes new x 8
91502A112_BLUE ALLOY STEEL SOCKET HEAD CAP SCREW new x 32
DYS 8108 x 5
lower link toe 20cm new x 4
top link 10cm new x 8
lower link 20cm new x 4
91259A541 new x 12
6655K330 x 24
95856A225 new x 12
6391K126 x 12
93070A067 new x 32
ghost minitaur side plate outer new x 2
ghost minitaur side panel outer new x 2
side panel new x 2
ghostminitaur side plates support new x 4
middle panel bottom new
picatinny rail new x 2
picatinny spacer new x 4
picatinny spacer with tab new x 2
battery holder new
ghost minitaur middle plate plastic cover new x 2
middle plate plastic cover cutouts new
ghost minitaur middle plate new
top cover plastic new
body bumper new
