marcelomata/MATLAB/Minitaur models/SM_Contact_Forces_Lib/SM_Contact_Forces_Lib_v3p5_R16b/Examples/2D/Geneva_Drive/CAD/Assembly/Geneva_Drive.SLDASM

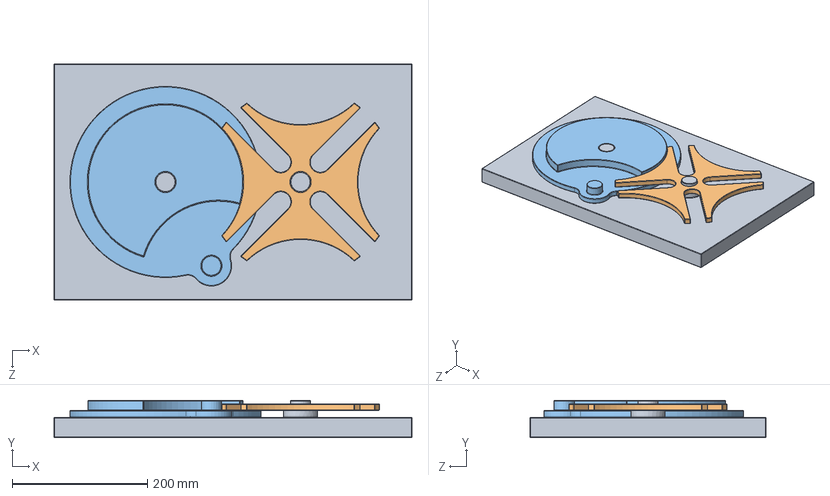
[picture p31: CAD file, 2017-04-27]
Minitaur models/SM_Contact_Forces_Lib/SM_Contact_Forces_Lib_v3p5_R16b/Examples/2D/Geneva_Drive/CAD/Assembly/Geneva_Drive.SLDASM
530.0 x 55.0 x 350.0 mm
Base
Geneva_Star
Drive_Wheel
