marcelomata/MATLAB/Minitaur models/model/minitaur-side-top-panel_Default_sldprt.STEP

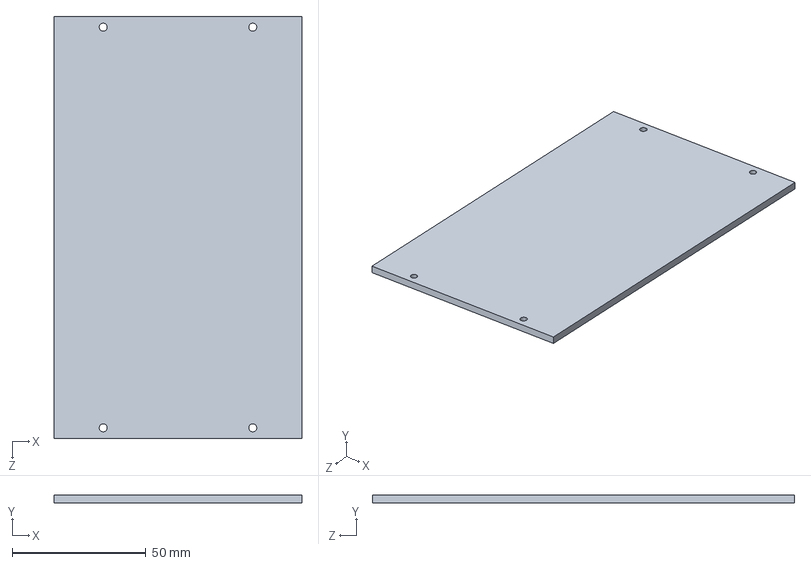
[picture p32: CAD file, 2017-04-27]
Minitaur models/model/minitaur-side-top-panel_Default_sldprt.STEP
92.7 x 3.00 x 158.0 mm
