marcelomata/MATLAB/Minitaur models/SM_Contact_Forces_Lib/SM_Contact_Forces_Lib_v3p4_R16a/Examples/2D/Geneva_Drive/CAD/Geometry/Drive_Wheel_Default_sldprt.STL

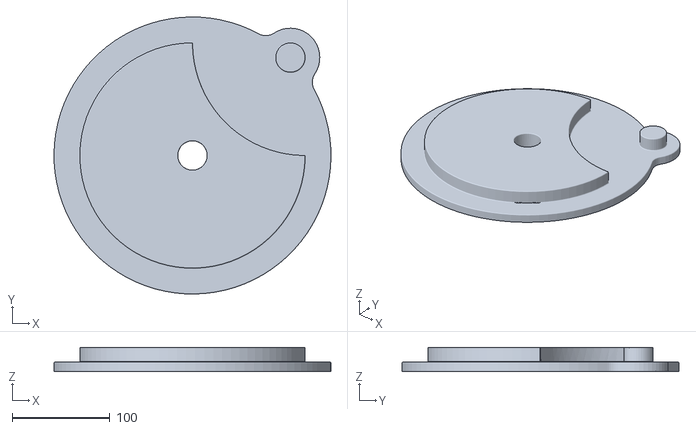
[picture p34: CAD file, 2017-04-27]
Minitaur models/SM_Contact_Forces_Lib/SM_Contact_Forces_Lib_v3p4_R16a/Examples/2D/Geneva_Drive/CAD/Geometry/Drive_Wheel_Default_sldprt.STL
282.8 x 282.8 x 25.0
