marcelomata/MATLAB/Minitaur models/SM_Contact_Forces_Lib/SM_Contact_Forces_Lib_v3p5_R16b/Examples/2D/Geneva_Drive/CAD/Assembly/Base.sldprt

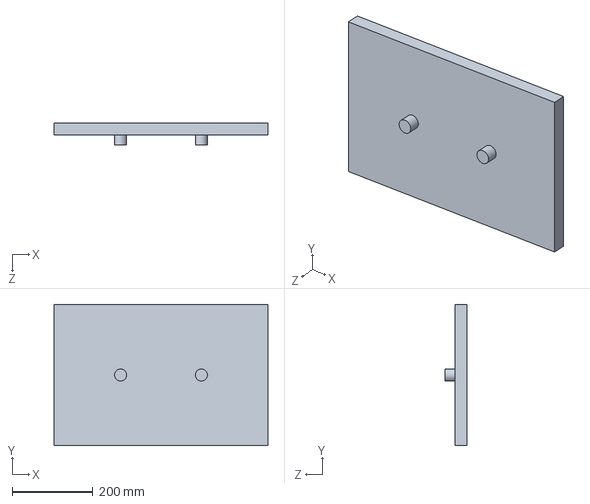
[picture p35: CAD file, 2017-04-27]
Minitaur models/SM_Contact_Forces_Lib/SM_Contact_Forces_Lib_v3p5_R16b/Examples/2D/Geneva_Drive/CAD/Assembly/Base.sldprt
530.0 x 350.0 x 55.0 mm
