marcelomata/MATLAB/Minitaur models/model/minitaur-side-panel_Default_sldprt.STEP

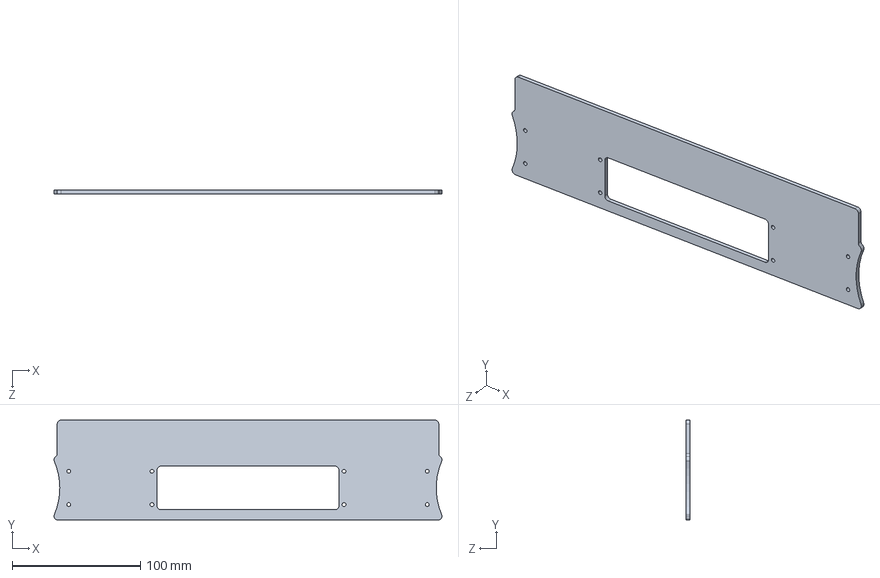
[picture p36: CAD file, 2017-04-27]
Minitaur models/model/minitaur-side-panel_Default_sldprt.STEP
303.0 x 78.0 x 3.00 mm
