marcelomata/MATLAB/Minitaur models/resources/cad/ash-minitaur-solidworks-assembly/DYS 8108 new.sldprt

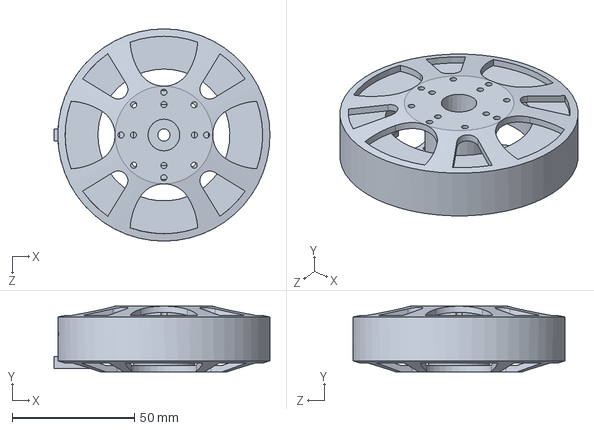
[picture p37: CAD file, 2017-04-27]
Minitaur models/resources/cad/ash-minitaur-solidworks-assembly/DYS 8108 new.sldprt
88.5 x 26.9 x 86.9 mm
