marcelomata/MATLAB/Minitaur models/model/minitaur-chassis-middle-plate-plastic-cover_Default_sldprt.STEP

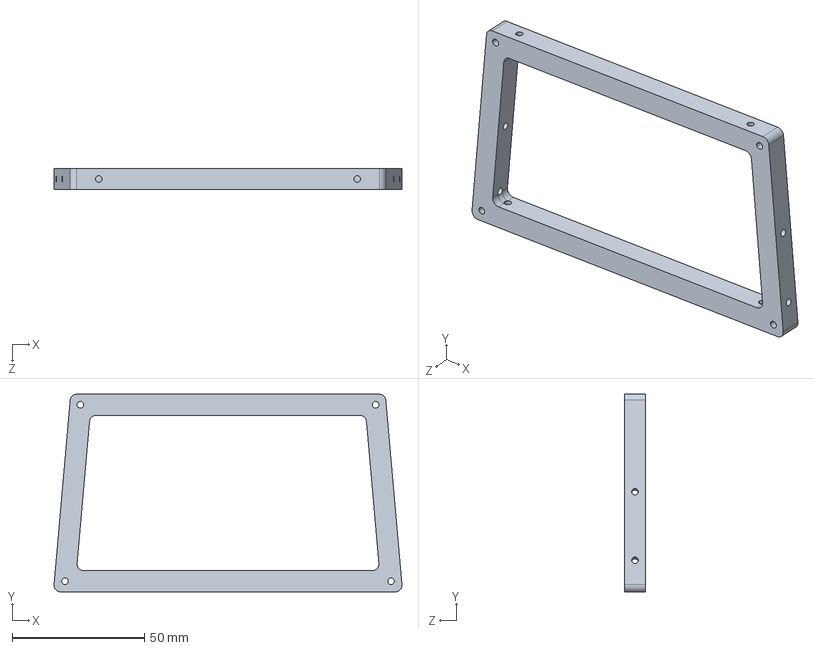
[picture p38: CAD file, 2017-04-27]
Minitaur models/model/minitaur-chassis-middle-plate-plastic-cover_Default_sldprt.STEP
131.5 x 74.7 x 8.00 mm
