marcelomata/MATLAB/Minitaur models/resources/cad/ash-minitaur-solidworks-assembly/picatinny spacer new.sldprt

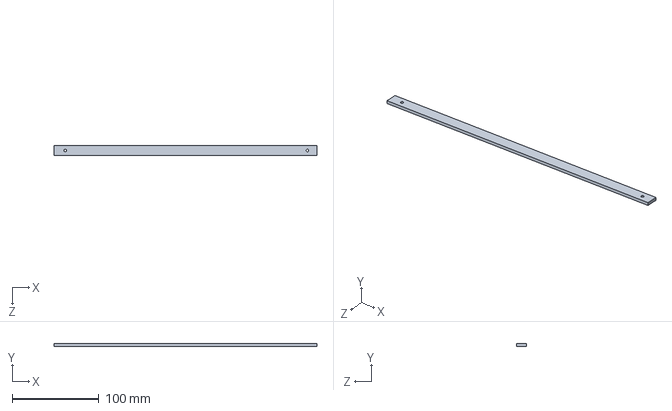
[picture p39: CAD file, 2017-04-27]
Minitaur models/resources/cad/ash-minitaur-solidworks-assembly/picatinny spacer new.sldprt
304.0 x 3.00 x 12.0 mm
