marcelomata/MATLAB/Minitaur models/SM_Contact_Forces_Lib/SM_Contact_Forces_Lib_v3p5_R16b/Examples/2D/Geneva_Drive/CAD/Assembly/Geneva.sldprt

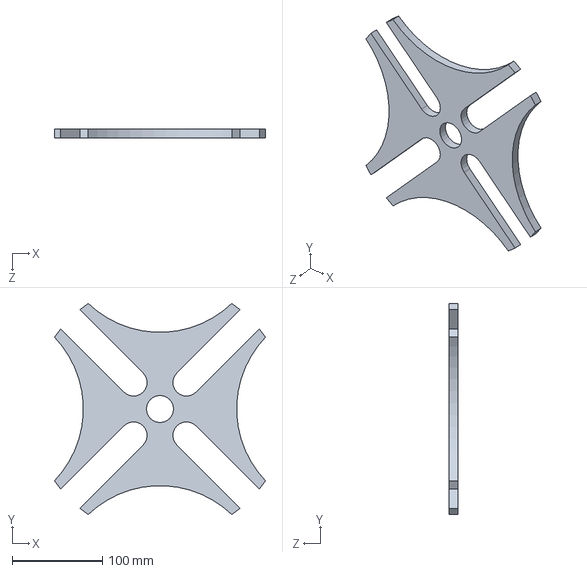
[picture p40: CAD file, 2017-04-27]
Minitaur models/SM_Contact_Forces_Lib/SM_Contact_Forces_Lib_v3p5_R16b/Examples/2D/Geneva_Drive/CAD/Assembly/Geneva.sldprt
233.9 x 233.9 x 10.0 mm
