marcelomata/MATLAB/Minitaur models/model/minitaur-battery-holder_Default_sldprt.STEP

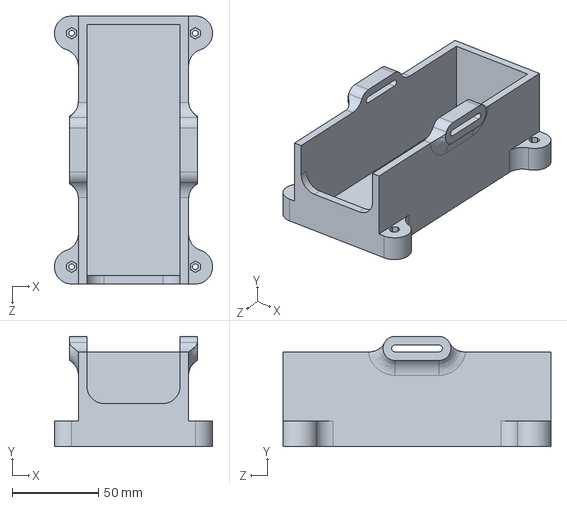
[picture p41: CAD file, 2017-04-27]
Minitaur models/model/minitaur-battery-holder_Default_sldprt.STEP
91.8 x 64.0 x 155.5 mm
