marcelomata/MATLAB/Minitaur models/resources/cad/ash-minitaur-solidworks-assembly/lower link 20cm new.sldprt

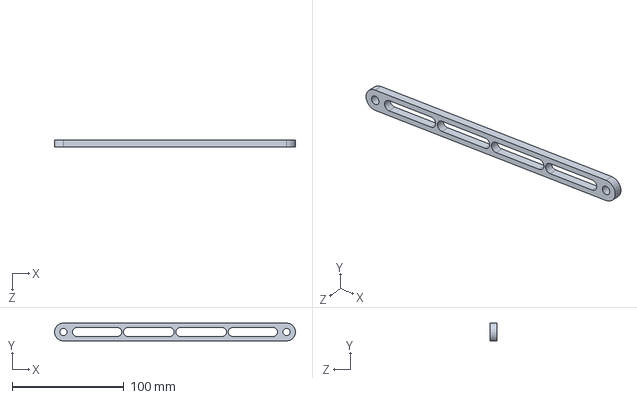
[picture p42: CAD file, 2017-04-27]
Minitaur models/resources/cad/ash-minitaur-solidworks-assembly/lower link 20cm new.sldprt
216.0 x 16.0 x 6.35 mm
