marcelomata/MATLAB/Minitaur models/model/minitaur-motor-driver-cover_Default_sldprt.STEP

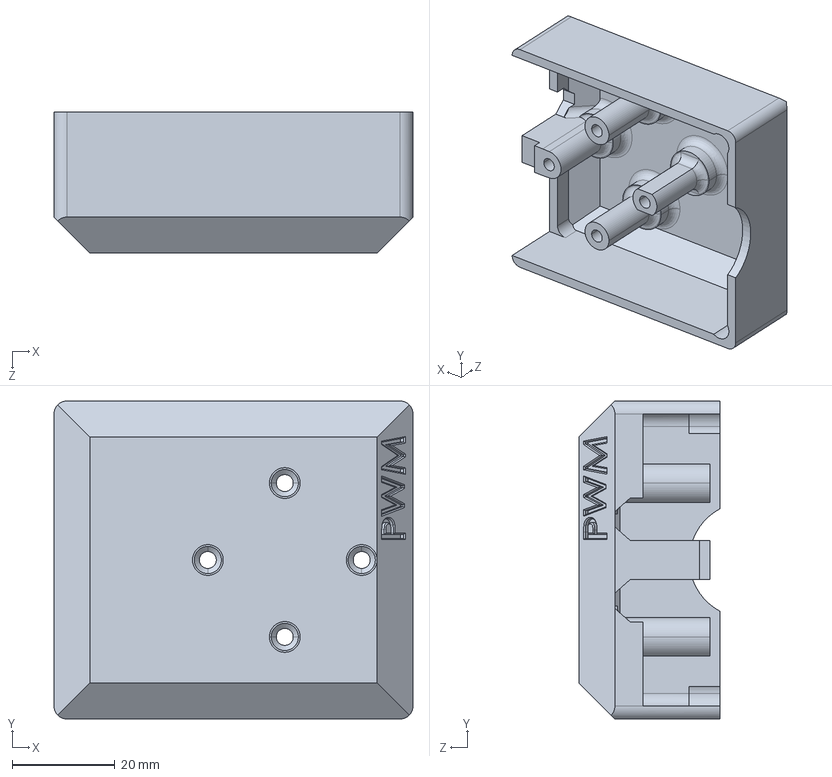
[picture p43: CAD file, 2017-04-27]
Minitaur models/model/minitaur-motor-driver-cover_Default_sldprt.STEP
70.0 x 62.0 x 27.5 mm
