marcelomata/MATLAB/Minitaur models/model/DYS-BLDC-86x10-BE8108-12-rotor_Default_sldprt.STEP

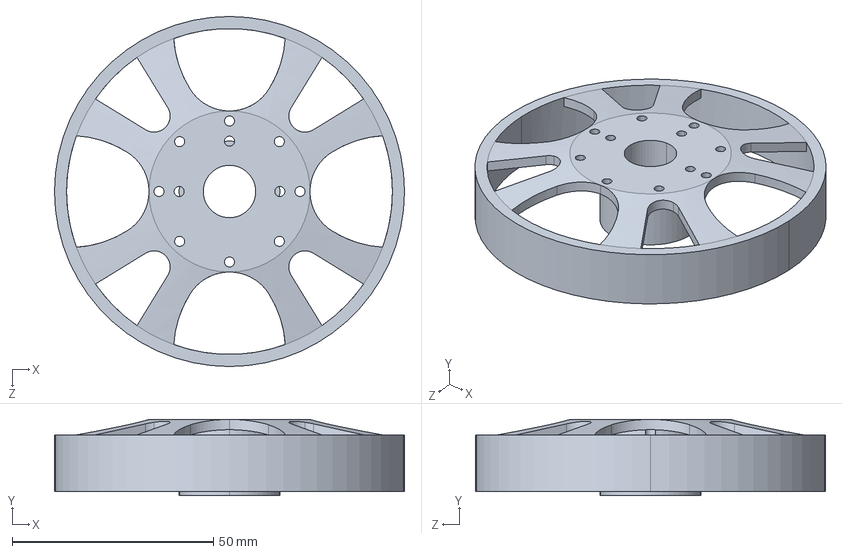
[picture p44: CAD file, 2017-04-27]
Minitaur models/model/DYS-BLDC-86x10-BE8108-12-rotor_Default_sldprt.STEP
86.9 x 18.9 x 86.9 mm
