marcelomata/MATLAB/Minitaur models/model/minitaur-side-support-plate_Default_sldprt.STEP

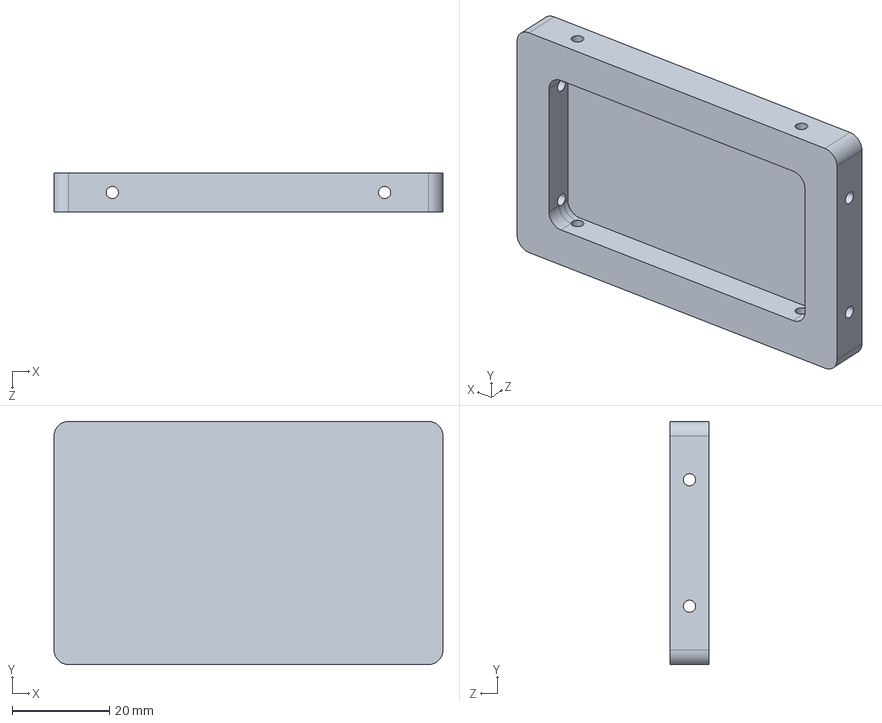
[picture p45: CAD file, 2017-04-27]
Minitaur models/model/minitaur-side-support-plate_Default_sldprt.STEP
80.0 x 50.0 x 8.00 mm
