marcelomata/MATLAB/Minitaur models/resources/cad/ash-minitaur-solidworks-assembly/top cover plastic new.sldprt

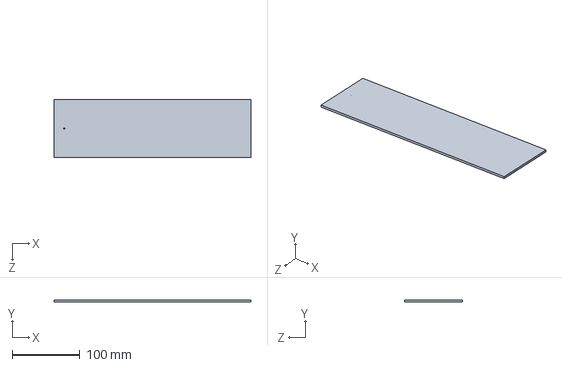
[picture p47: CAD file, 2017-04-27]
Minitaur models/resources/cad/ash-minitaur-solidworks-assembly/top cover plastic new.sldprt
291.0 x 3.00 x 85.0 mm
