marcelomata/MATLAB/Minitaur models/model/minitaur-leg-upper-link_Default_sldprt.STEP

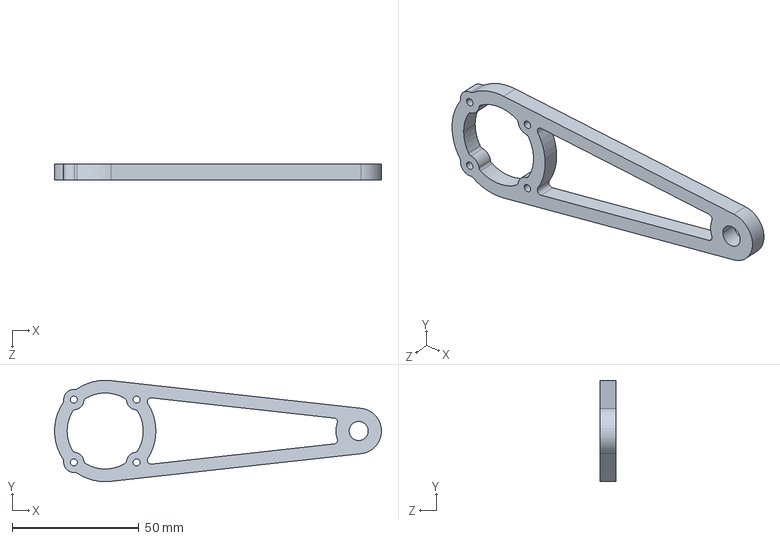
[picture p48: CAD file, 2017-04-27]
Minitaur models/model/minitaur-leg-upper-link_Default_sldprt.STEP
129.0 x 40.0 x 6.35 mm
