marcelomata/MATLAB/Minitaur models/resources/cad/ash-minitaur-solidworks-assembly/bllc0p61 new.sldprt

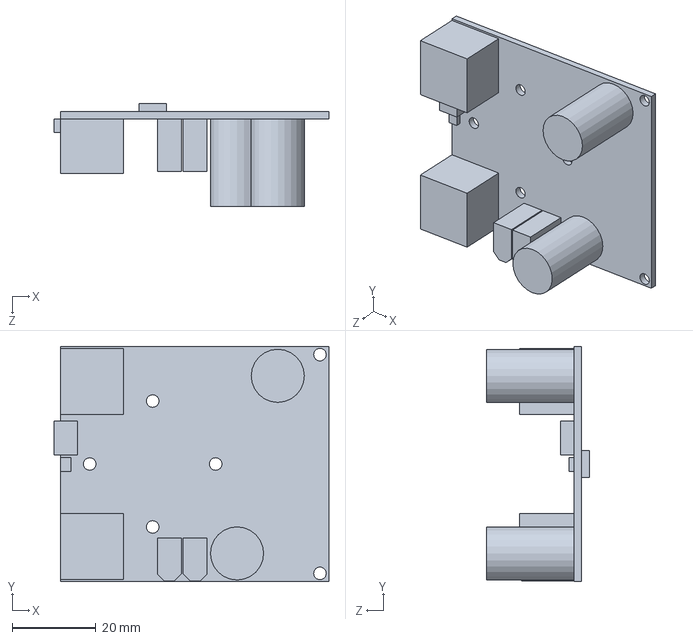
[picture p49: CAD file, 2017-04-27]
Minitaur models/resources/cad/ash-minitaur-solidworks-assembly/bllc0p61 new.sldprt
65.5 x 56.0 x 24.4 mm
