marcelomata/MATLAB/Minitaur models/resources/cad/ash-minitaur-solidworks-assembly/ghost minitaur side plate outer new.sldprt

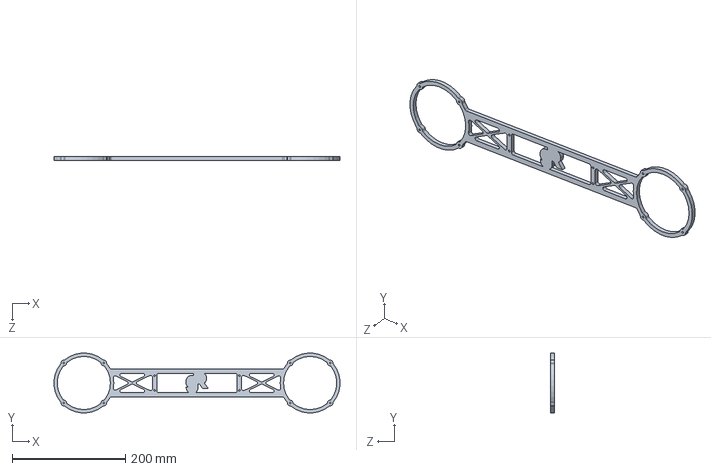
[picture p51: CAD file, 2017-04-27]
Minitaur models/resources/cad/ash-minitaur-solidworks-assembly/ghost minitaur side plate outer new.sldprt
505.5 x 105.5 x 6.35 mm
