marcelomata/MATLAB/Minitaur models/resources/cad/ash-minitaur-solidworks-assembly/module plate u8 moreholes new.sldprt

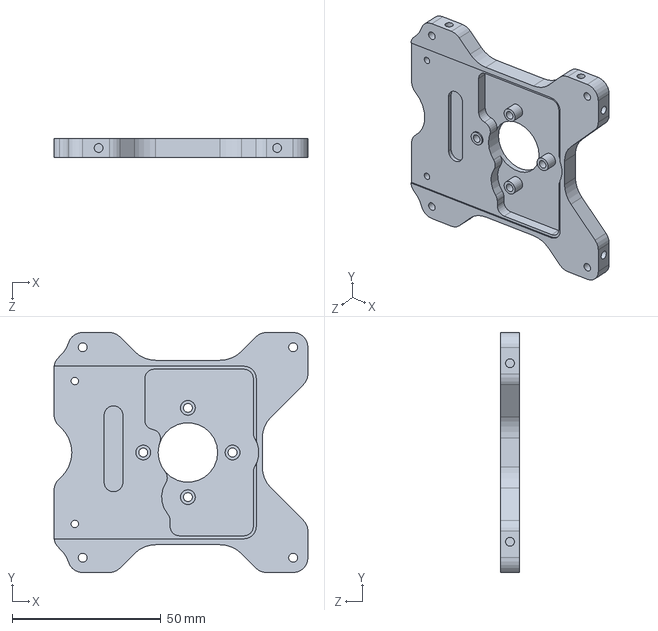
[picture p52: CAD file, 2017-04-27]
Minitaur models/resources/cad/ash-minitaur-solidworks-assembly/module plate u8 moreholes new.sldprt
85.4 x 80.7 x 6.35 mm
