marcelomata/MATLAB/Minitaur models/resources/cad/ash-minitaur-solidworks-assembly/module u8 bllc cover XT60 new.sldprt

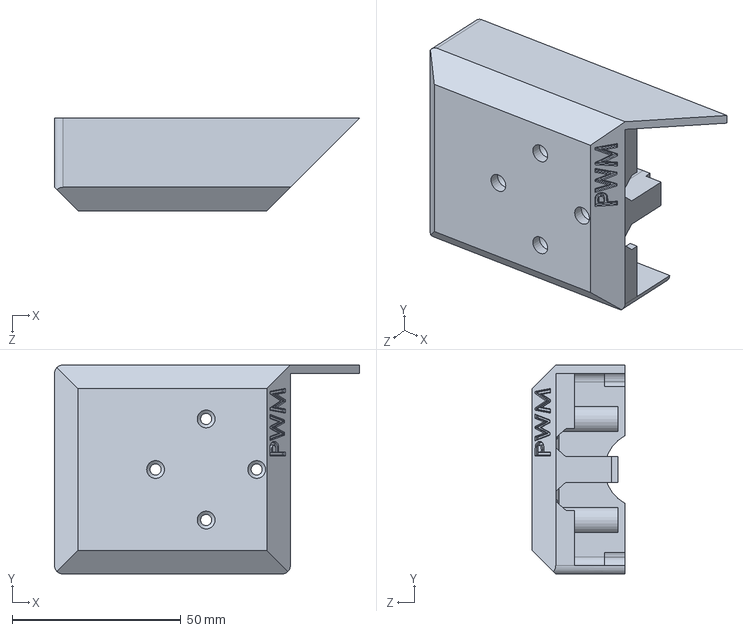
[picture p53: CAD file, 2017-04-27]
Minitaur models/resources/cad/ash-minitaur-solidworks-assembly/module u8 bllc cover XT60 new.sldprt
90.5 x 62.0 x 27.5 mm
