marcelomata/MATLAB/Minitaur models/model/minitaur-battery-placeholder_Default_sldprt.STEP

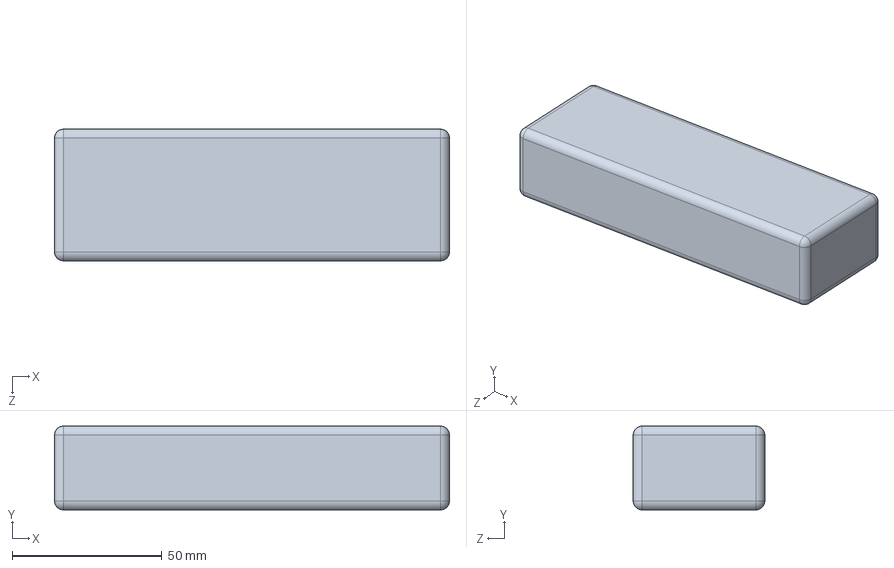
[picture p54: CAD file, 2017-04-27]
Minitaur models/model/minitaur-battery-placeholder_Default_sldprt.STEP
132.0 x 28.0 x 44.0 mm
