marcelomata/MATLAB/Minitaur models/model/minitaur-leg-joint-placeholder-sim_Default_sldprt.STEP

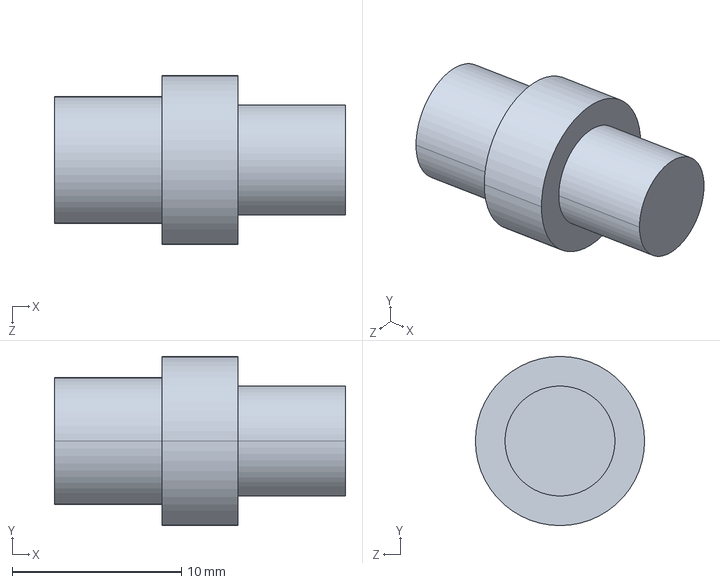
[picture p55: CAD file, 2017-04-27]
Minitaur models/model/minitaur-leg-joint-placeholder-sim_Default_sldprt.STEP
17.2 x 10.0 x 10.0 mm
