marcelomata/MATLAB/Minitaur models/model/minitaur-chassis-bottom-panel_Default_sldprt.STEP

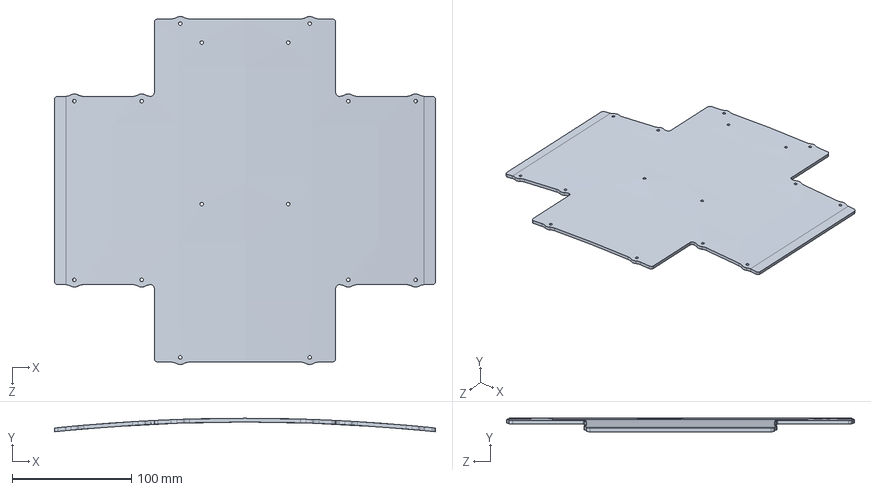
[picture p56: CAD file, 2017-04-27]
Minitaur models/model/minitaur-chassis-bottom-panel_Default_sldprt.STEP
320.1 x 11.4 x 292.0 mm
