marcelomata/MATLAB/Minitaur models/resources/cad/ash-minitaur-solidworks-assembly/picatinny spacer with tab new.sldprt

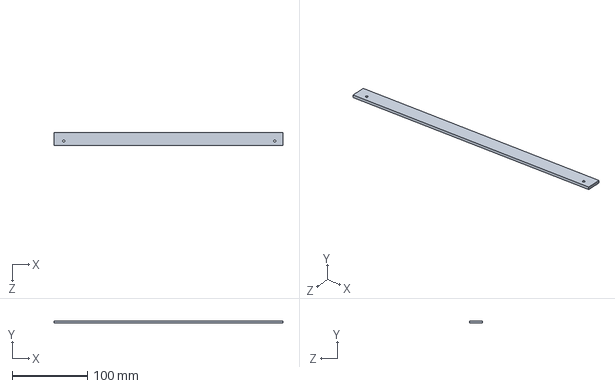
[picture p57: CAD file, 2017-04-27]
Minitaur models/resources/cad/ash-minitaur-solidworks-assembly/picatinny spacer with tab new.sldprt
304.0 x 3.00 x 17.0 mm
