marcelomata/MATLAB/Minitaur models/model/minitaur-middle-plate_Default_sldprt.STEP

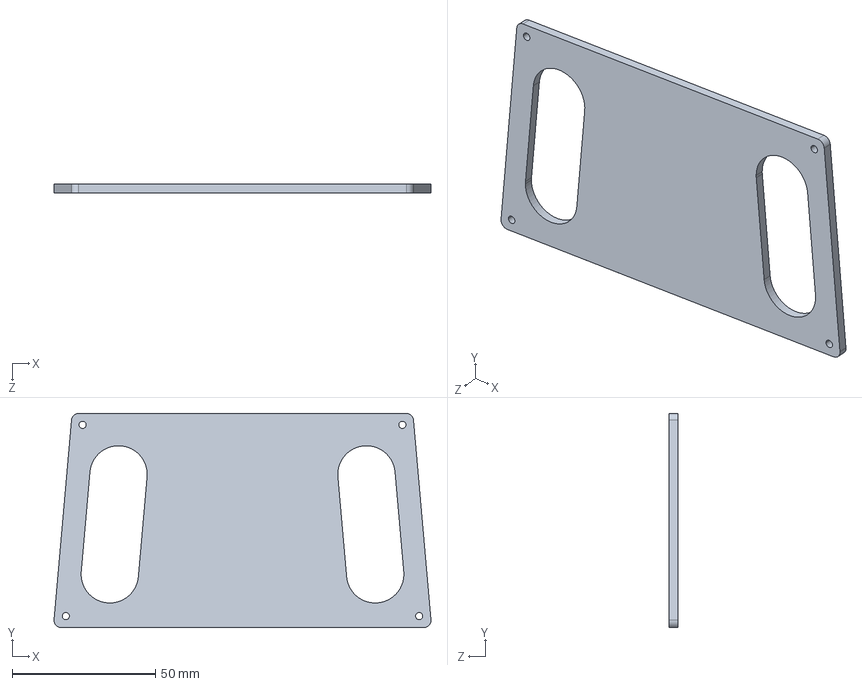
[picture p58: CAD file, 2017-04-27]
Minitaur models/model/minitaur-middle-plate_Default_sldprt.STEP
131.5 x 74.7 x 3.00 mm
