marcelomata/MATLAB/Minitaur models/resources/cad/ash-minitaur-solidworks-assembly/body bumper new.sldprt

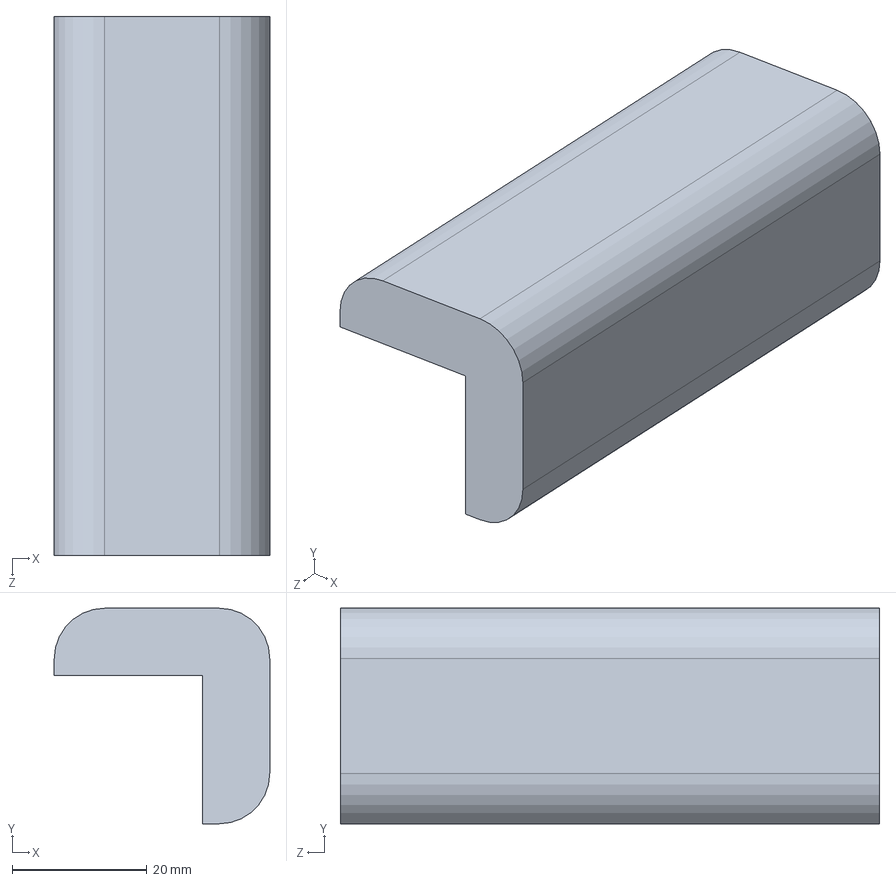
[picture p59: CAD file, 2017-04-27]
Minitaur models/resources/cad/ash-minitaur-solidworks-assembly/body bumper new.sldprt
32.0 x 32.0 x 80.0 mm
