marcelomata/MATLAB/Minitaur models/model/minitaur-chassis-middle-plate-plastic-cover-cutouts_Default_sldprt.STEP

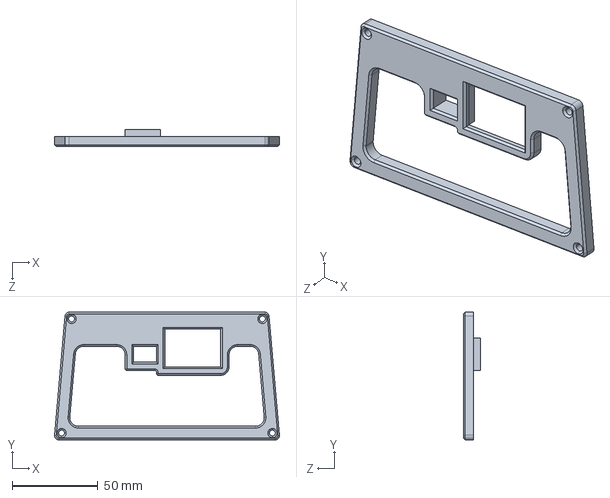
[picture p60: CAD file, 2017-04-27]
Minitaur models/model/minitaur-chassis-middle-plate-plastic-cover-cutouts_Default_sldprt.STEP
131.5 x 74.7 x 10.0 mm
