marcelomata/MATLAB/Minitaur models/model/DYS-BLDC-86x10-BE8108-12-stator_Default_sldprt.STEP

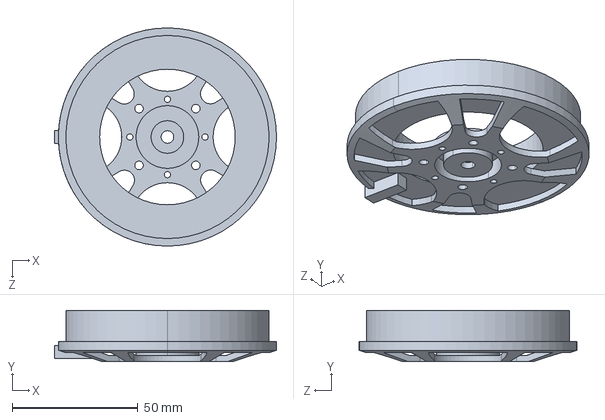
[picture p61: CAD file, 2017-04-27]
Minitaur models/model/DYS-BLDC-86x10-BE8108-12-stator_Default_sldprt.STEP
88.5 x 20.4 x 86.9 mm
