marcelomata/MATLAB/Minitaur models/model/minitaur-leg-lower-link-toe_Default_sldprt.STEP

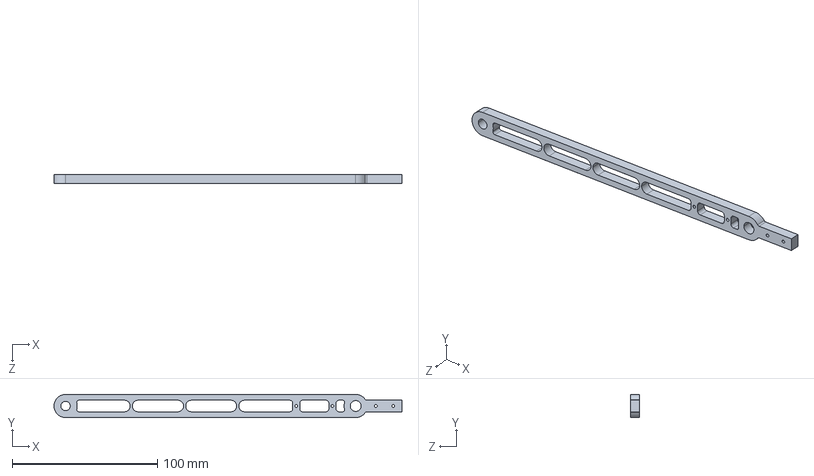
[picture p62: CAD file, 2017-04-27]
Minitaur models/model/minitaur-leg-lower-link-toe_Default_sldprt.STEP
239.9 x 16.0 x 6.35 mm
