marcelomata/MATLAB/Minitaur models/model/minitaur-side-plate-outer_Default_sldprt.STEP

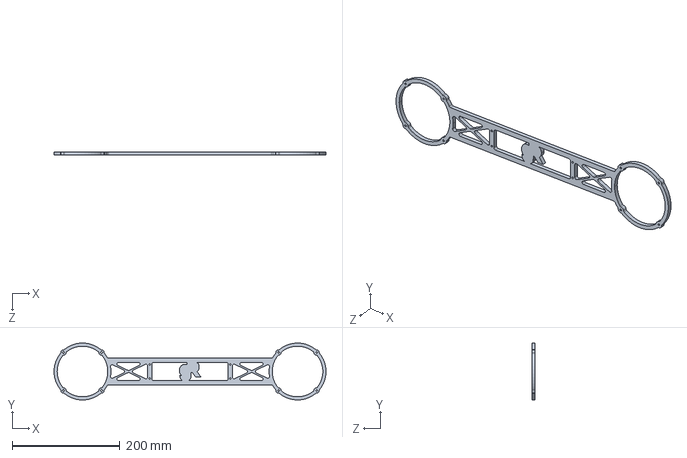
[picture p63: CAD file, 2017-04-27]
Minitaur models/model/minitaur-side-plate-outer_Default_sldprt.STEP
505.9 x 105.8 x 6.35 mm
