marcelomata/MATLAB/Minitaur models/model/minitaur-chassis-top-panel_Default_sldprt.STEP

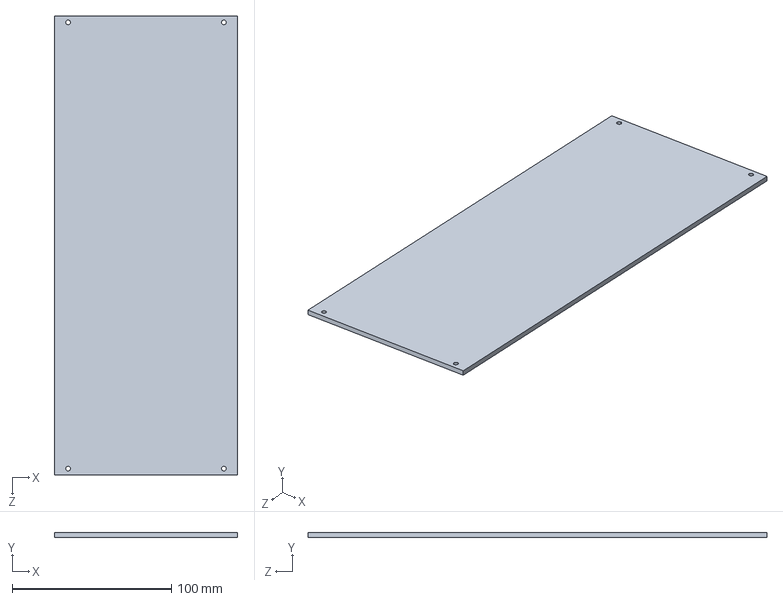
[picture p64: CAD file, 2017-04-27]
Minitaur models/model/minitaur-chassis-top-panel_Default_sldprt.STEP
115.0 x 3.00 x 288.0 mm
