marcelomata/MATLAB/Minitaur models/resources/cad/ash-minitaur-solidworks-assembly/lower link toe 20cm new.sldprt

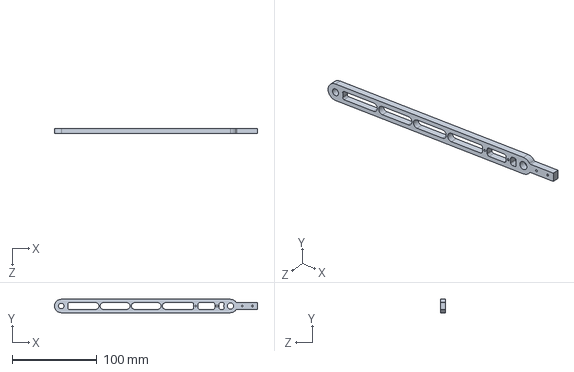
[picture p65: CAD file, 2017-04-27]
Minitaur models/resources/cad/ash-minitaur-solidworks-assembly/lower link toe 20cm new.sldprt
239.9 x 16.0 x 6.35 mm
