marcelomata/MATLAB/Minitaur models/resources/cad/ash-minitaur-solidworks-assembly/top link 10cm new.sldprt

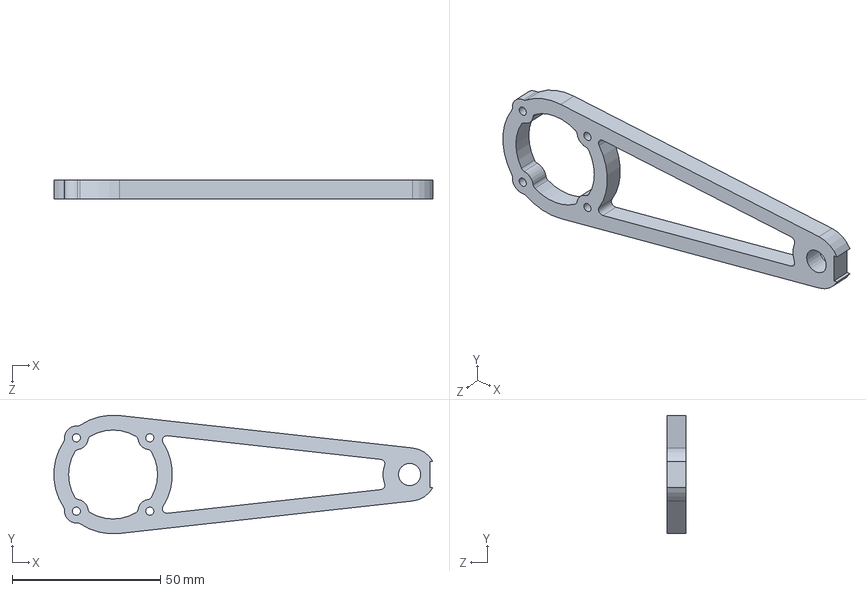
[picture p66: CAD file, 2017-04-27]
Minitaur models/resources/cad/ash-minitaur-solidworks-assembly/top link 10cm new.sldprt
127.8 x 39.9 x 6.35 mm
