marcelomata/MATLAB/Minitaur models/resources/cad/ash-minitaur-solidworks-assembly/middle panel bottom new.sldprt

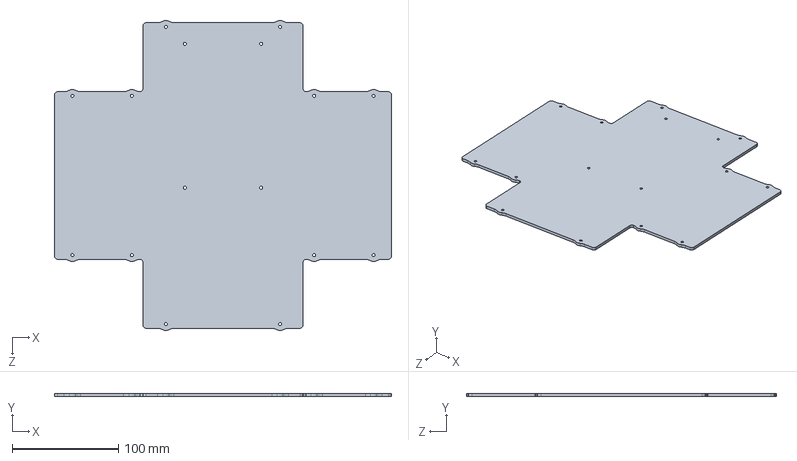
[picture p67: CAD file, 2017-04-27]
Minitaur models/resources/cad/ash-minitaur-solidworks-assembly/middle panel bottom new.sldprt
317.4 x 3.17 x 292.0 mm
