marcelomata/MATLAB/Minitaur models/resources/cad/ash-minitaur-solidworks-assembly/picatinny rail new.sldprt

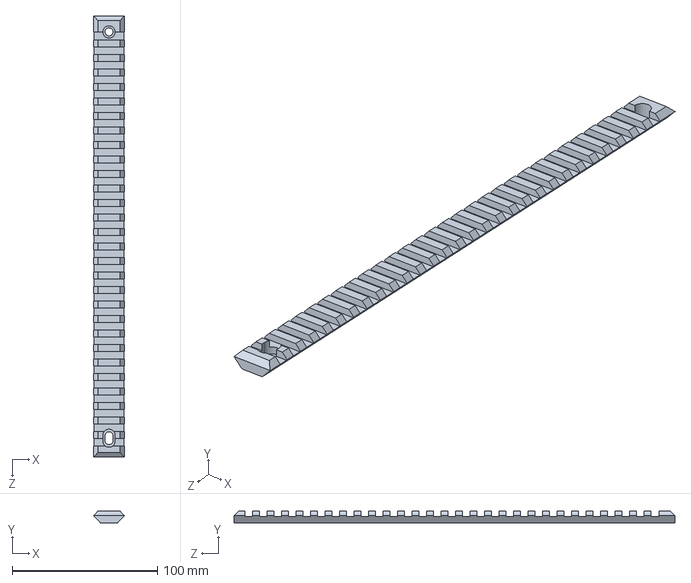
[picture p68: CAD file, 2017-04-27]
Minitaur models/resources/cad/ash-minitaur-solidworks-assembly/picatinny rail new.sldprt
21.2 x 8.00 x 304.0 mm
