marcelomata/MATLAB/(list of files, cad)

Other CAD files:
Minitaur models/SM_Contact_Forces_Lib/SM_Contact_Forces_Lib_v3p5_R16b/Examples/2D/Geneva_Drive/CAD/Geometry/Base_Default_sldprt.STL
Minitaur models/SM_Contact_Forces_Lib/SM_Contact_Forces_Lib_v3p4_R16a/Examples/2D/Geneva_Drive/CAD/Geometry/Base_Default_sldprt.STL
Minitaur models/SM_Contact_Forces_Lib/SM_Contact_Forces_Lib_v3p5_R16b/Examples/2D/Geneva_Drive/CAD/Assembly/Drive_Wheel.sldprt
Minitaur models/resources/cad/ash-minitaur-solidworks-assembly/battery holder new.sldprt
Minitaur models/SM_Contact_Forces_Lib/SM_Contact_Forces_Lib_v3p5_R16b/Examples/2D/Geneva_Drive/CAD/Assembly/Part.SLDPRT
Minitaur models/resources/cad/ash-minitaur-solidworks-assembly/side panel new.sldprt
Minitaur models/model/minitaur-leg-lower-link_Default_sldprt.STEP
Minitaur models/model/minitaur-side-plate_Default_sldprt.STEP
Minitaur models/model/minitaur-motor-module-plate_Default_sldprt.STEP
Minitaur models/resources/cad/ash-minitaur-solidworks-assembly/ghost minitaur side panel outer new.sldprt
Minitaur models/model/minitaur-motor-driver-board_Default_sldprt.STEP
Minitaur models/resources/cad/ash-minitaur-solidworks-assembly/ghost minitaur middle plate plastic cover new.sldprt
Minitaur models/resources/cad/ash-minitaur-solidworks-assembly/ghostminitaur side plates support new.sldprt
Minitaur models/resources/cad/ash-minitaur-solidworks-assembly/middle plate plastic cover cutouts new.sldprt
Minitaur models/resources/cad/ash-minitaur-solidworks-assembly/ghost minitaur middle plate new.sldprt
Minitaur models/model/2517T32_Default_sldprt.STEP
Minitaur models/resources/cad/ash-minitaur-solidworks-assembly/6391K126 new.sldprt
Minitaur models/resources/cad/ash-minitaur-solidworks-assembly/6655K330 new.sldprt
Minitaur models/resources/cad/ash-minitaur-solidworks-assembly/91259A541 new.sldprt
Minitaur models/resources/cad/ash-minitaur-solidworks-assembly/91502A112_BLUE ALLOY STEEL SOCKET HEAD CAP SCREW new.sldprt
Minitaur models/resources/cad/ash-minitaur-solidworks-assembly/93070A067 new.sldprt
Minitaur models/resources/cad/ash-minitaur-solidworks-assembly/95856A225 new.sldprt
Minitaur models/resources/cad/ash-minitaur-solidworks-assembly/DYS 8108 new - Copy.sldprt
Minitaur models/resources/cad/gr-minitaur-fusion/ghost minitaur full robot.f3d
Minitaur models/resources/cad/gr-minitaur-fusion/ghost minitaur full robot.f3z
