marcelomata/MATLAB/Minitaur models/SM_Contact_Forces_Lib/SM_Contact_Forces_Lib_v3p0_R14b/Scripts_Data/CFR_Results.xlsx

 | Contact Forces Tests | 8.4.0.150421 (R2014b) |  |  | 2015-08-05 12:47
 |  |  | Linear, No Friction |  | Linear, Stick-Slip C |  | Nonlin., No Friction |  | Nonlin., Stick-Slip C
# | Model | Stop Time | # Steps | Sim Time | # Steps | Sim Time | # Steps | Sim Time | # Steps | Sim Time
1 | Collision_01_Ball_Infinite_Plane | 20.00 | 3960 | 0.37 | 3960 | 0.21 | 3960 | 0.21 | 3960 | 0.20
2 | Collision_02_Disk_Finite_Plane_Fixed | 4.00 | 671 | 0.14 | 980 | 0.09 | 703 | 0.07 | 999 | 0.10
3 | Collision_03_Disk_Finite_Plane_Spin | 1.50 | 340 | 0.12 | 395 | 0.06 | 356 | 0.06 | 425 | 0.06
4 | Collision_04_Disks_in_Box | 3.00 | 3819 | 2.62 | 4402 | 2.83 | 5187 | 3.02 | 6215 | 4.04
5 | Collision_05_Disk_in_Ring | 5.00 | 1964 | 0.25 | 2563 | 0.23 | 2200 | 0.18 | 2989 | 0.26
6 | Collision_06_Catapult | 1.20 | 638 | 0.21 | 645 | 0.14 | 724 | 0.15 | 734 | 0.17
7 | Collision_07_Ball_Finite_Plane_Float | 1.50 | 213 | 0.16 | 214 | 0.09 | 223 | 0.08 | 228 | 0.09
8 | Collision_08_Compare_Forces | 5.00 | 9846 | 2.78 | 18411 | 5.60 | 12950 | 4.07 | 20891 | 7.10
9 | Friction_01_Box_on_Ramp_Constraint | 10.00 | 1211 | 0.16 | 1211 | 0.09 | 1211 | 0.09 | 1211 | 0.08
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
