marcelomata/MATLAB/Minitaur models/SM_Contact_Forces_Lib/SM_Contact_Forces_Lib_v3p4_R16a/Scripts_Data/CFR_Results.xlsx

 | Contact Forces Tests | 9.0.0.341360 (R2016a) |  |  | 2016-04-15 16:44
 |  |  | Linear, No Friction |  | Linear, Stick-Slip C |  | Nonlin., No Friction |  | Nonlin., Stick-Slip C
# | Model | Stop Time | # Steps | Sim Time | # Steps | Sim Time | # Steps | Sim Time | # Steps | Sim Time
1 | Collision_01_Ball_Infinite_Plane | 6.00 | 2387 | 0.43 | 2387 | 0.20 | 2387 | 0.19 | 2387 | 0.19
2 | Collision_02_Disk_Finite_Plane_Fixed | 4.00 | 669 | 0.34 | 990 | 0.09 | 721 | 0.07 | 1015 | 0.11
3 | Collision_03_Disk_Finite_Plane_Spin | 1.50 | 298 | 0.13 | 365 | 0.06 | 317 | 0.07 | 400 | 0.07
4 | Collision_04_Disks_in_Box | 3.00 | 3714 | 1.98 | 4403 | 2.59 | 5062 | 2.92 | 6266 | 4.06
5 | Collision_05_Disk_in_Ring | 5.00 | 2058 | 0.22 | 2681 | 0.25 | 2266 | 0.19 | 2983 | 0.35
6 | Collision_06_Catapult | 1.20 | 619 | 0.17 | 608 | 0.11 | 745 | 0.13 | 681 | 0.14
7 | Collision_07_Ball_Finite_Plane_Float | 1.50 | 200 | 0.05 | 207 | 0.04 | 213 | 0.03 | 221 | 0.03
8 | Collision_08_Compare_Forces | 5.00 | 10055 | 3.40 | 18563 | 7.16 | 12458 | 4.82 | 20798 | 9.02
9 | Friction_01_Box_on_Ramp_Constraint | 10.00 | 1211 | 0.15 | 1211 | 0.09 | 1211 | 0.09 | 1211 | 0.09
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
