marcelomata/MATLAB/Minitaur models/SM_Contact_Forces_Lib/SM_Contact_Forces_Lib_v3p5_R16b/Scripts_Data/CFR_Results.xlsx

 | Contact Forces Tests | 9.1.0.441655 (R2016b) |  |  | 2017-01-15 09:07 |  | CFL v3.5
 |  |  | Linear, No Friction |  | Linear, Stick-Slip C |  | Nonlin., No Friction |  | Nonlin., Stick-Slip C
# | Model | Stop Time | # Steps | Sim Time | # Steps | Sim Time | # Steps | Sim Time | # Steps | Sim Time
1 | Collision_01_Ball_Infinite_Plane | 6.00 | 2400 | 0.84 | 2400 | 0.73 | 2400 | 0.20 | 2400 | 0.19
2 | Collision_02_Disk_Finite_Plane_Fixed | 4.00 | 674 | 0.38 | 959 | 0.09 | 731 | 0.07 | 1028 | 0.10
3 | Collision_03_Disk_Finite_Plane_Spin | 1.50 | 311 | 0.17 | 366 | 0.07 | 317 | 0.05 | 397 | 0.06
4 | Collision_04_Disks_in_Box | 3.00 | 3805 | 2.08 | 4277 | 2.46 | 4676 | 2.65 | 6400 | 4.17
5 | Collision_05_Disk_in_Ring | 5.00 | 2040 | 0.22 | 2678 | 0.34 | 2284 | 0.20 | 2932 | 0.36
6 | Collision_06_Catapult | 1.20 | 616 | 0.16 | 607 | 0.12 | 745 | 0.13 | 672 | 0.13
7 | Collision_07_Ball_Finite_Plane_Float | 1.50 | 200 | 0.05 | 207 | 0.03 | 213 | 0.03 | 221 | 0.03
8 | Collision_08_Compare_Forces | 5.00 | 10055 | 3.01 | 18563 | 6.83 | 12458 | 4.43 | 20798 | 8.87
9 | Friction_01_Box_on_Ramp_Constraint | 10.00 | 1211 | 0.16 | 1211 | 0.10 | 1211 | 0.10 | 1211 | 0.09
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
