marcelomata/MATLAB/(commit log)

2017-04-27 Add Spring 2017, Minitaur models
2017-04-27 Add Minitaur models
    [2517T32_Default_sldprt.STEP, 6391K126 new.sldprt, 6655K330 new.sldprt, 91259A541 new.sldprt, 91502A112_BLUE ALLOY STEEL SOCKET HEAD CAP SCREW new.sldprt, 93070A067 new.sldprt, 95856A225 new.sldprt, Base.sldprt]
